lucaspcamargo/hydrus-v1/docs/pics/test-live.jpg

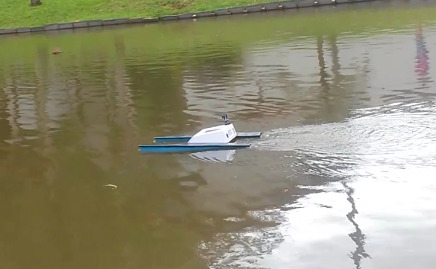
docs/pics/test-live.jpg
