lucaspcamargo/hydrus-v1/docs/proposal/concept-render.jpg

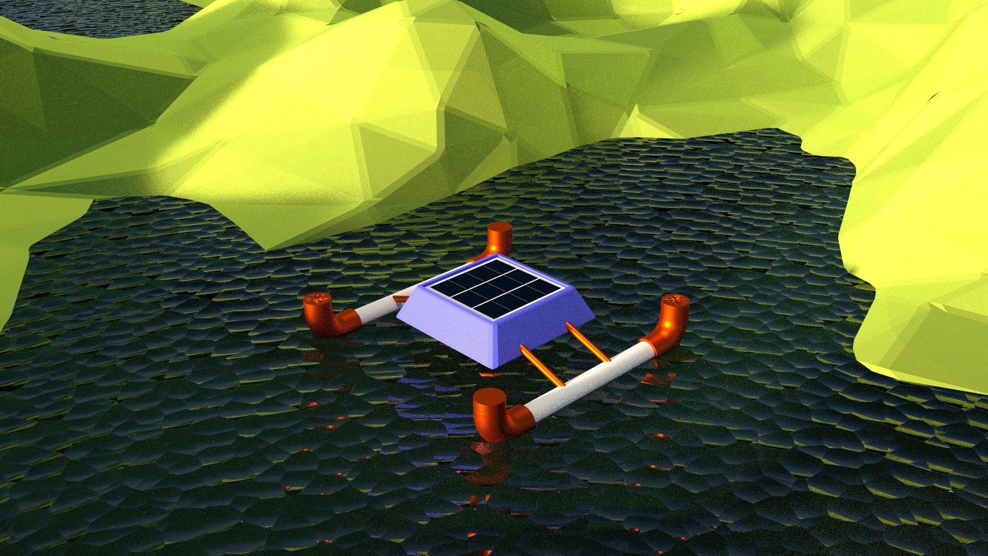
docs/proposal/concept-render.jpg
