lucaspcamargo/hydrus-v1/README.md

# Hydrus v1

Project files for the first version of the Hydrus vehicle (hw, sw, and docs).
