lucaspcamargo/hydrus-v1/docs/banner/method-darkbg.pdf

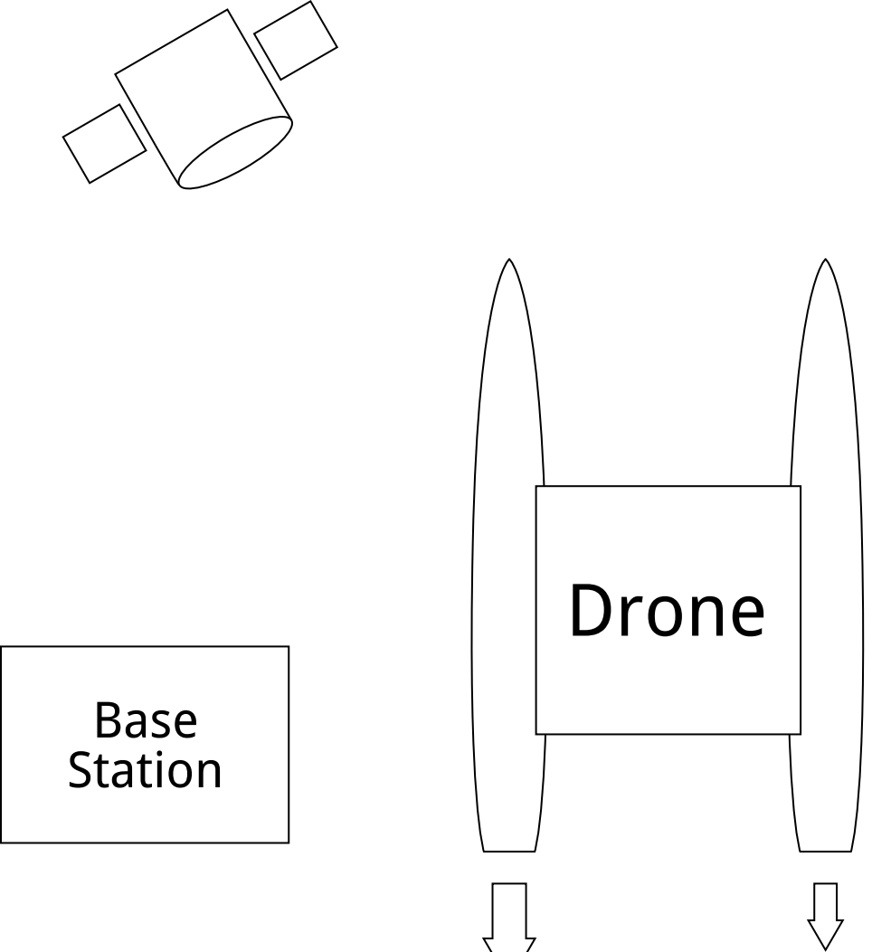
[picture p31: figure]
Drone; - Water PH - Temperature - Turbidity; Base Station; WiFi; GPS; Sensors:; Thrust Vectoring
