lucaspcamargo/hydrus-v1/docs/presentation/presentation.pdf

## Intel Embedded Systems Competition 2016

Organization | Promotion | Sponsorship

# Hydrus – Autonomous Drone for Hydrologic Monitoring

Lucas Pires Camargo
Guilherme Augusto Pangratz
Êmili Bohrer

Professor: Giovani Gracioli
University: Federal University of Santa Catarina – UFSC

# The Hydrus Project

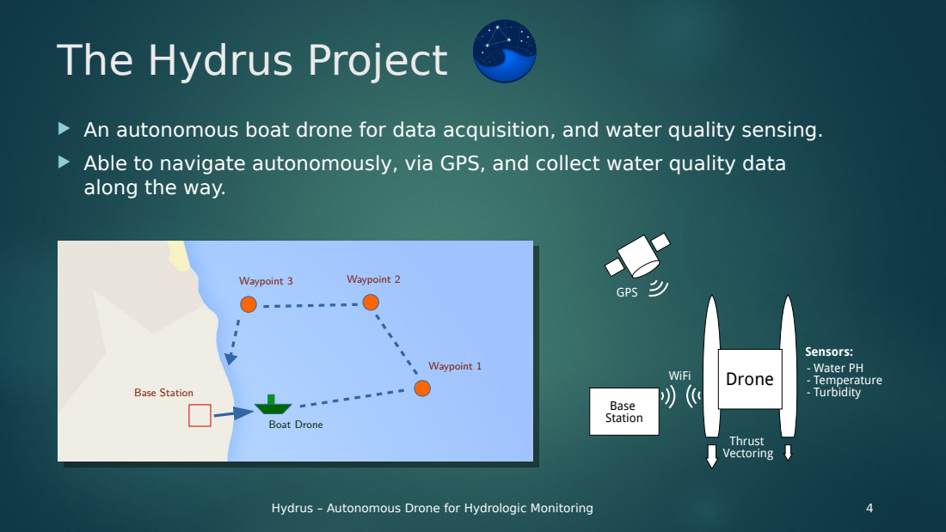
[picture p32: page 2]
Hydrus – Autonomous Drone for Hydrologic Monitoring; Drone; - Water PH - Temperature - Turbidity; Base Station; WiFi; GPS; Sensors:; Thrust Vectoring; Waypoint 3; Waypoint 2; Waypoint 1; Boat Drone

υ An autonomous boat drone for data acquisition, and water quality sensing.
υ Able to navigate autonomously, via GPS, and collect water quality data
along the way.

# Why is it important?

υ 65% of sewage in Brazil is dumped untreated (IGBE + SNIS 2014)
υ Manual monitoring of water in reservoirs is expensive, slow, and sparse.
υ Advances in technology and lowering costs can help solve problems more easily. υ Our drone can…
Increase the number of measurements. Geotag all measurements by default.

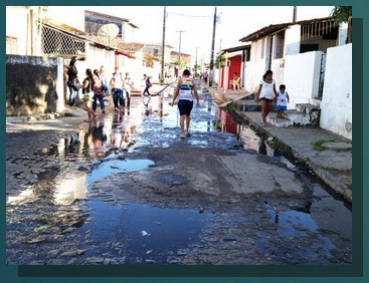
[picture p33: figure]

Open sewage in João Pessoa, PB Source: goo.gl/34XWrf

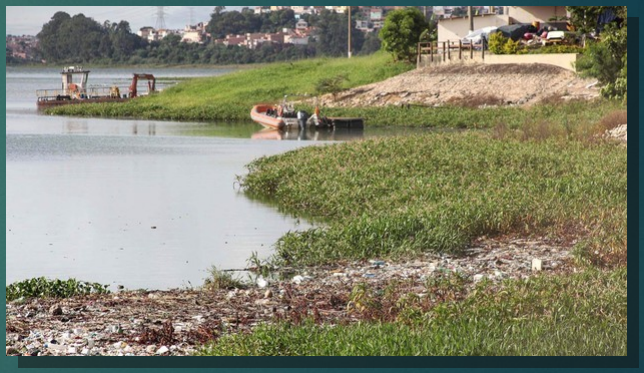
[picture p34: figure]

Garbage floating in a SP reservoir Source: goo.gl/SnBXYp

# Boat Frame

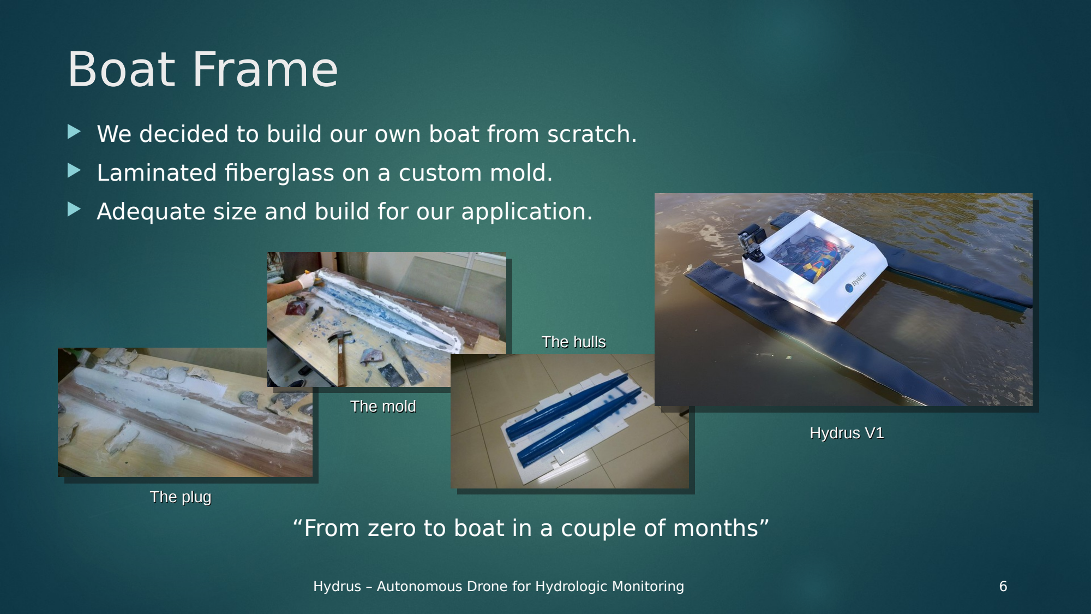
[picture p35: page 4]

υ We decided to build our own boat from scratch. υ Laminated fiberglass on a custom mold.
υ Adequate size and build for our application.

“From zero to boat in a couple of months”

The plug

The mold

The hulls

Hydrus V1

# Hardware

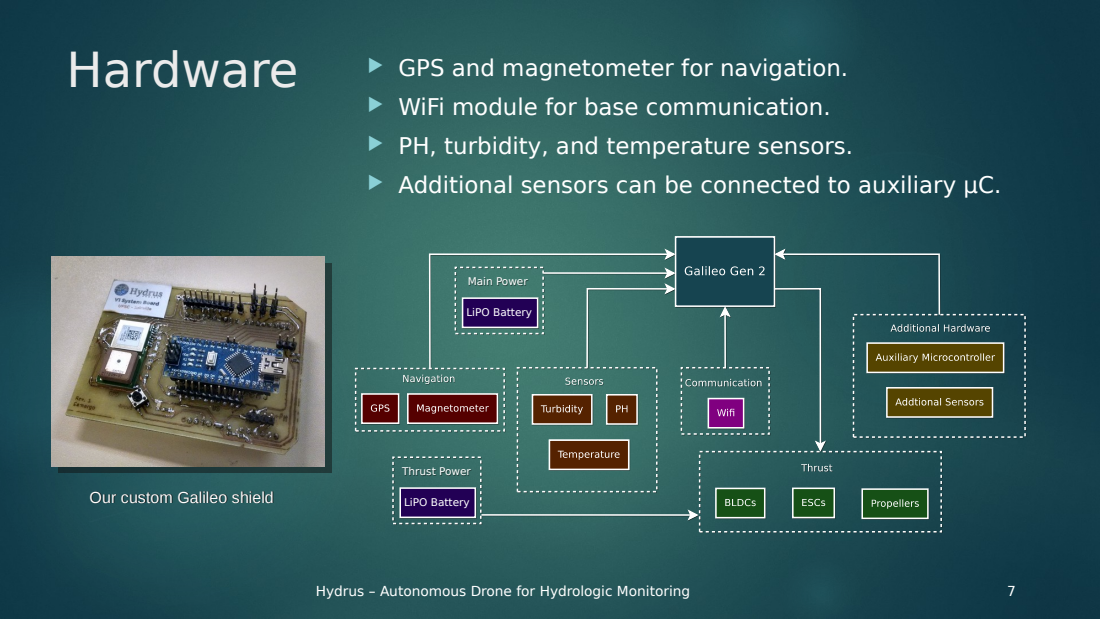
[picture p36: page 5]
Thrust Power; LiPO Battery; Main Power

υ GPS and magnetometer for navigation.
υ WiFi module for base communication.
υ PH, turbidity, and temperature sensors.
υ Additional sensors can be connected to auxiliary µC.

Our custom Galileo shield

# Software

υ Custom built C / C++ firmware, with standard IoT image. υ Cyclic executive scheduler + blackboard architecture.

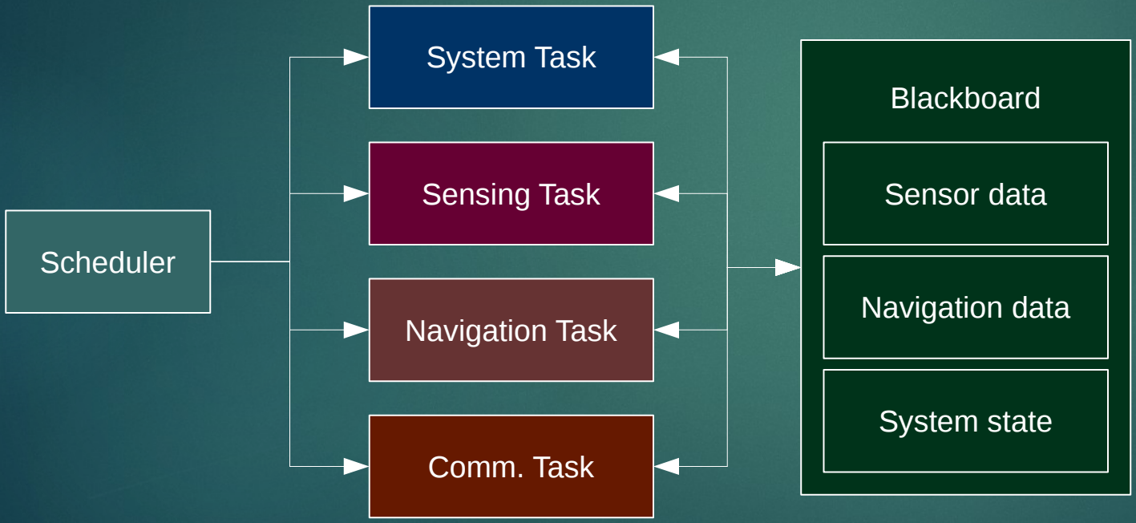
[picture p37: figure]
Scheduler; System Task; Sensing Task; Navigation Task; Comm. Task; Blackboard; Sensor data; System state; Navigation data

Task | Execute (A) | Execute (B) | Period
System | ✓ | ✓ | 0.02s
Sense | ✓ | ✓ | 0.02s
Nav | ✓ | | 0.04s
Comm | | ✓ | 0.04s

Cyclic task Schedule. Major period is 0.04s

# Base Station Software

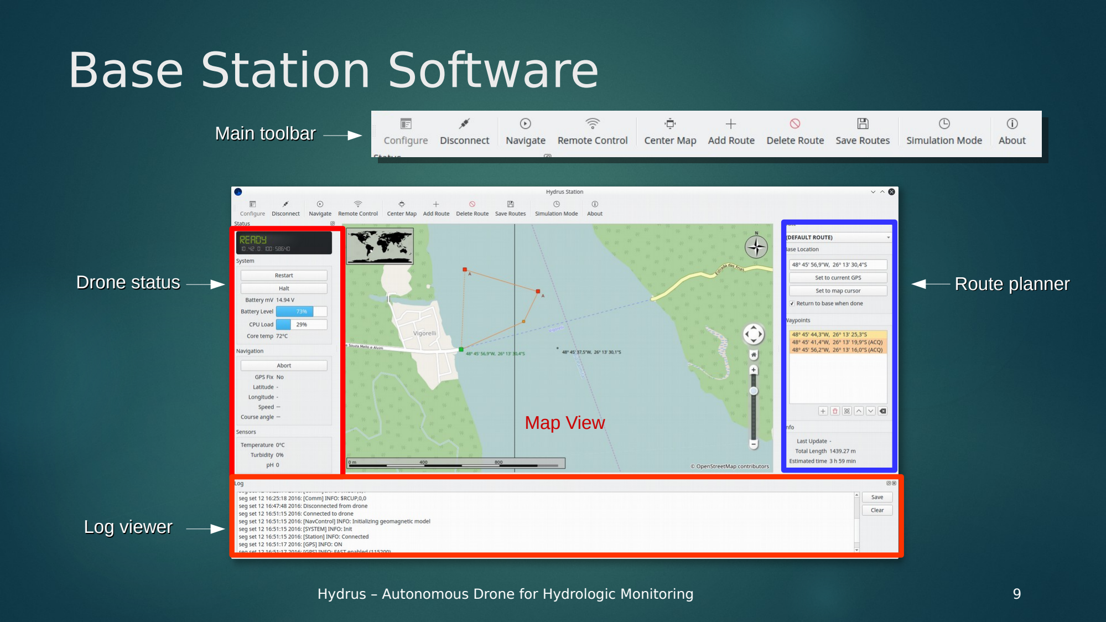
[picture p38: page 7]

Log viewer

Drone status

Main toolbar

Route planner

Map View

# Technical issues

υ We found the Galileo Gen 2 board to be very sensitive.
- Inadequate inrush current protection: we had the regulator catch fire because we plugged the board to a lithium battery (14.5V).
- There should be a separate I2C bus for the onboard peripherals: any interference would bring the sketch to a halt.
- We bricked one probably because the IOREF jumper was loose...

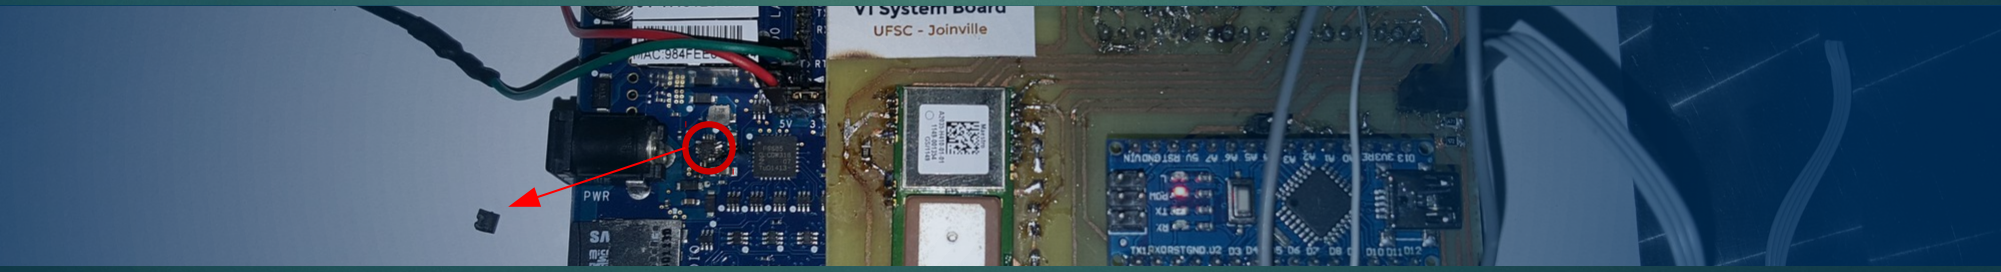
[picture p39: figure]

# Workarounds

υ A couple of boards were brought back to life by supplying +5V directly.
υ We created a GPS-publisher phone app for situations it was hard to get the GPS module to fix to the satellites.
- Overcast weather, old almanac data, etc
Regulator + Filter | Galileo Gen 2

5V_ALWAYS_ON

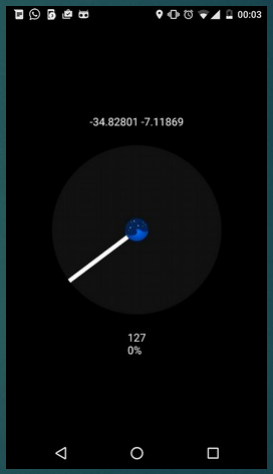
[picture p40: figure]

Helper Android application

Simple solution for blownup regulator (U6)

# Why the project is innovative?

υ A handmade, low-cost boat drone that can navigate autonomously, and collect data on water quality along the way.
υ Modular hardware and software. Custom physical frame.
υ Our drone is a framework that can be easily extended to support additional sensors and applications.

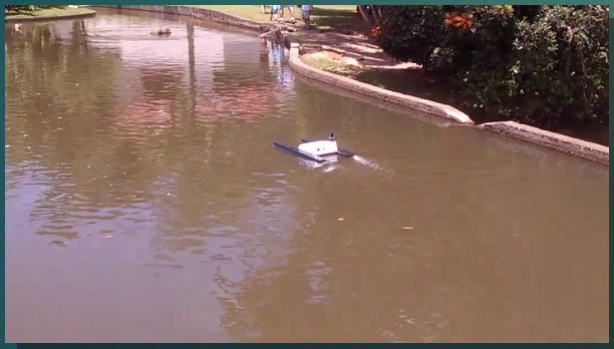
[picture p41: figure]

Item | Price (USD)
Boat frame | $60.00
Battery + Powertrain | $51.00
Galileo Gen 2 | $77.00
Sensors and Modules | $129.00
Total | $317.00

# Results and Future Plans

υ The drone is able to reach programmed waypoints and navigate correctly. υ The companion application allows the user to plot collected data spatially. υ We plan to study the usage of the boat for sonar bathymetry applications. υ We also want to investigate additional energy sources, such as solar.

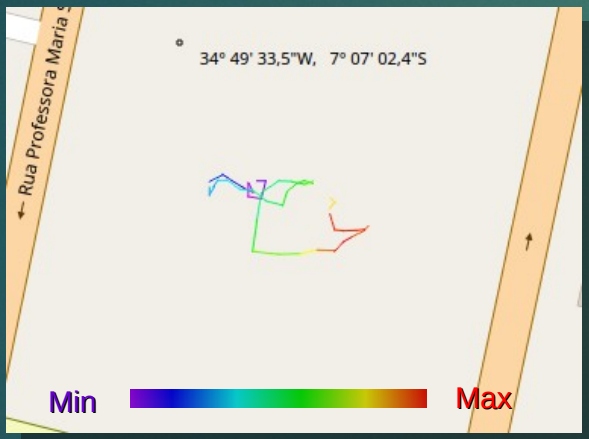
[picture p42: figure]
Min; Max

Plot of collected temperature data on a mock route

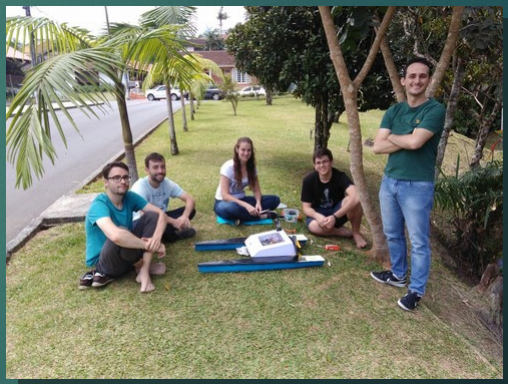
[picture p43: figure]

## Intel® Embedded Systems Competition 2016

# Thank you for your attention!

# Questions?

Organization | Promotion | Sponsorship
