lucaspcamargo/hydrus-v1/docs/software/sw-uml-sense.pdf

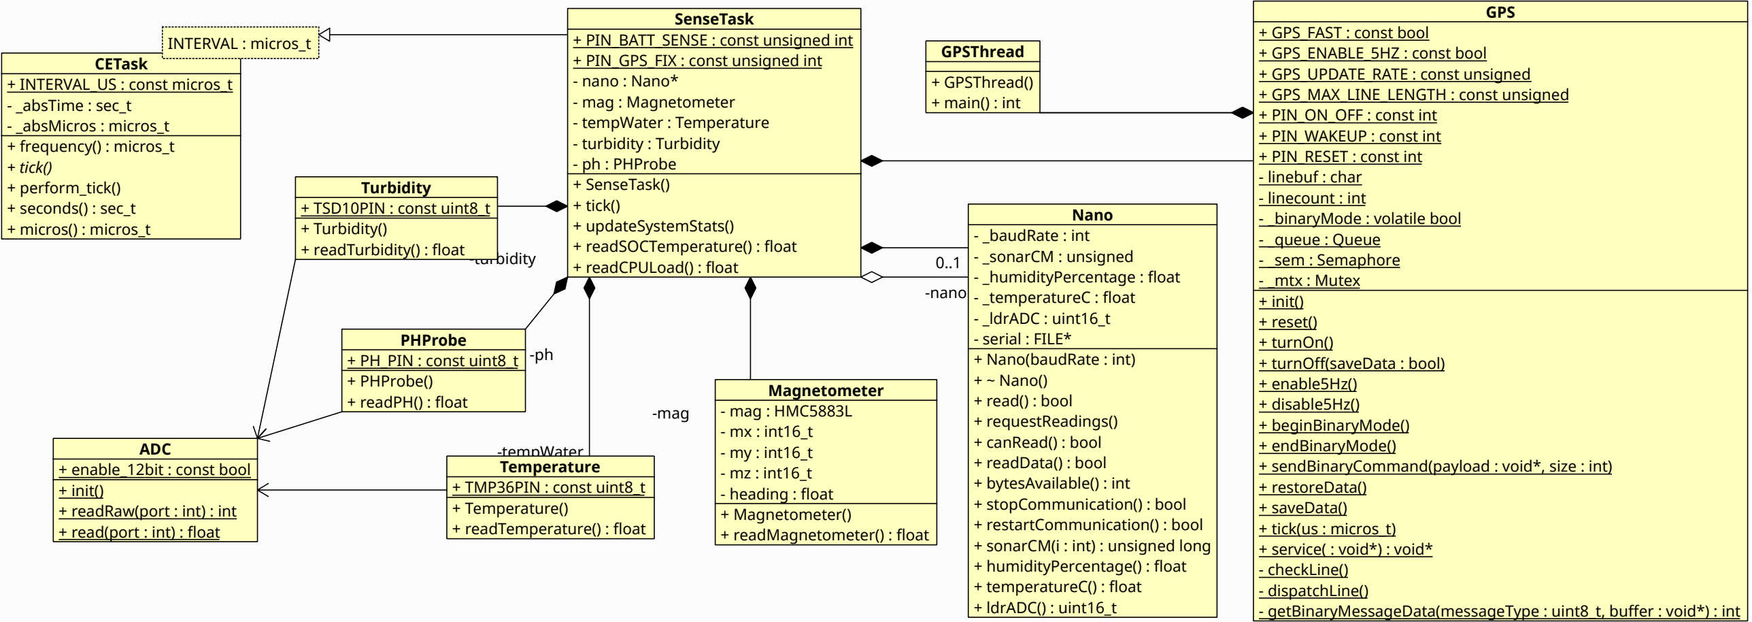
[picture p46: figure]
-turbidity; -mag; ADC + enable_12bit : const bool + init() + readRaw(port : int) : int + read(port : int) : float; 0..1 -nano; -tempWater; INTERVAL : micros_t; CETask + INTERVAL_US : const micros_t - _absTime : sec_t - _absMicros : micros_t + frequency() : micros_t + tick() + perform_tick() + seconds() : sec_t + micros() : micros_t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

+ sendBinaryCommand(payload : void*, size : int)

- getBinaryMessageData(messageType : uint8_t, buffer : void*) : int
