lucaspcamargo/hydrus-v1/docs/branding/board-backside.png

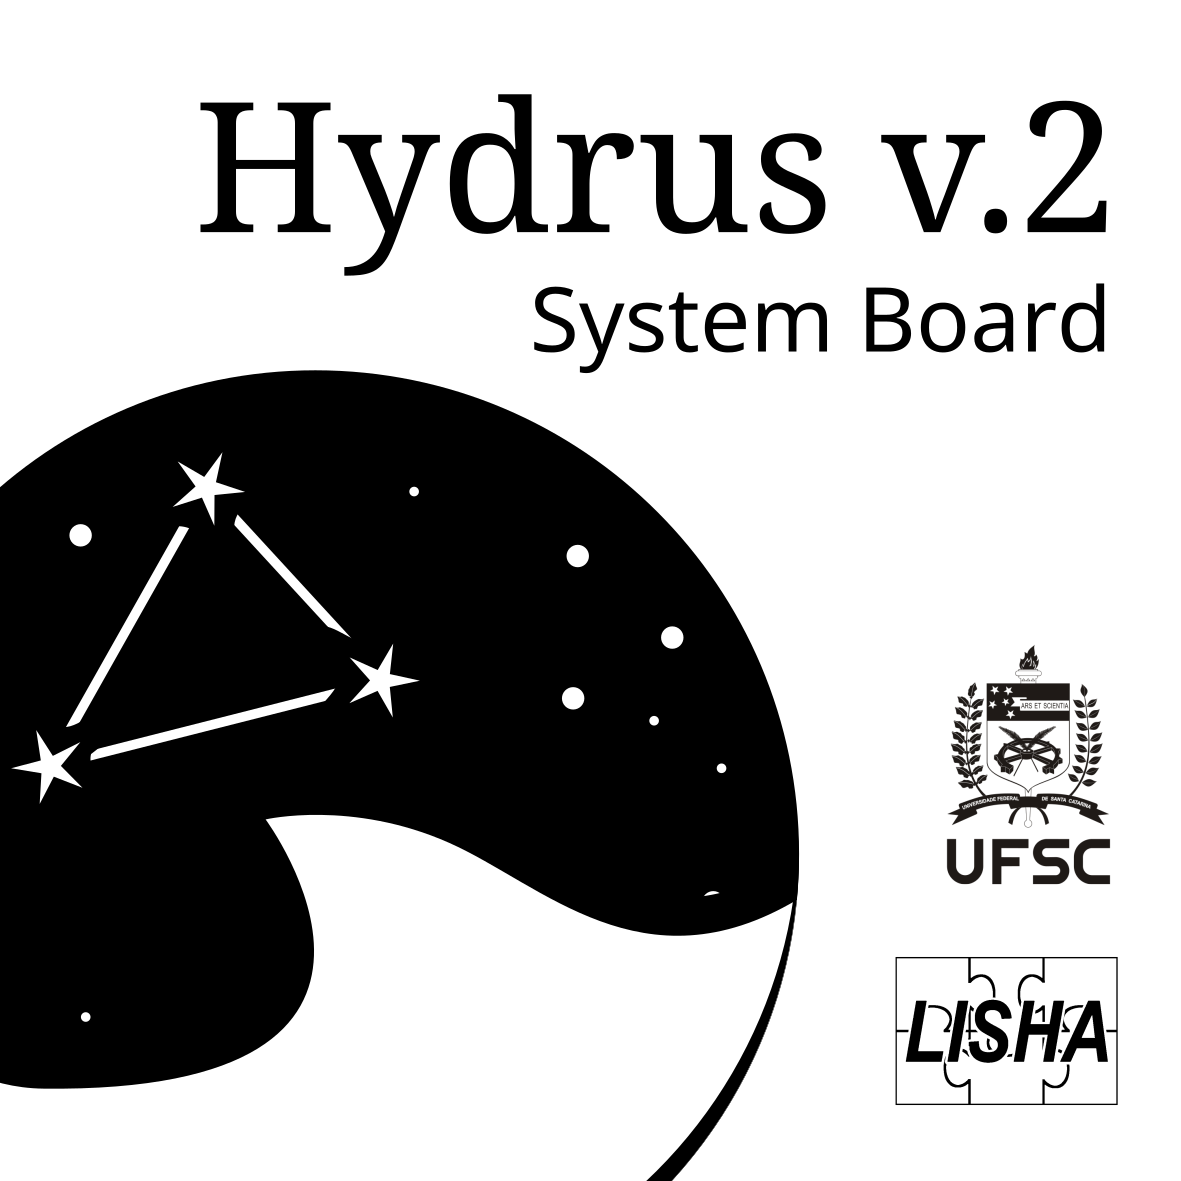
docs/branding/board-backside.png
