lucaspcamargo/hydrus-v1/docs/pics/IMG-20161026-WA0012.jpg

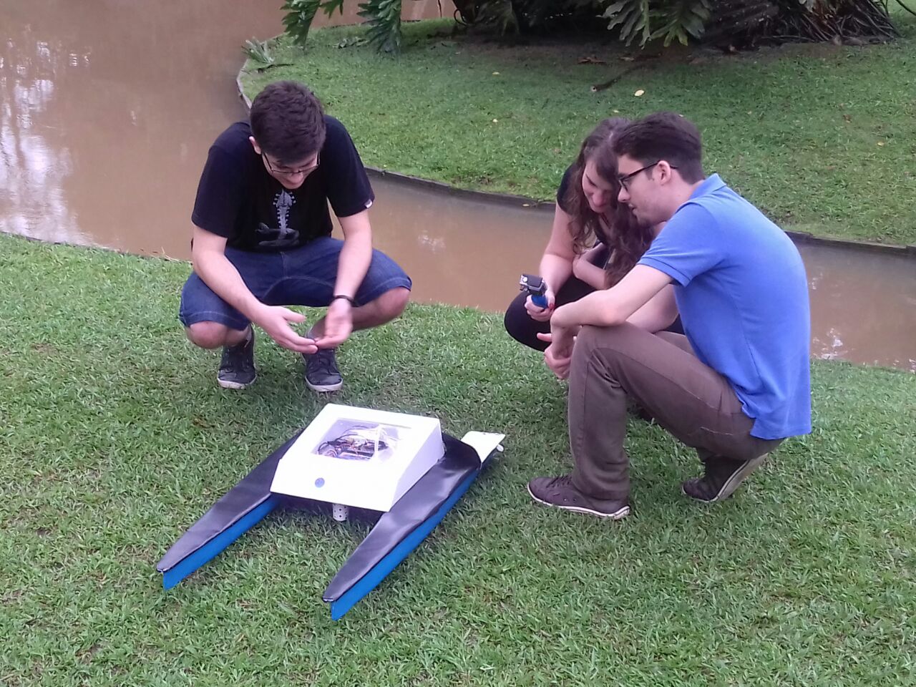
docs/pics/IMG-20161026-WA0012.jpg
