lucaspcamargo/hydrus-v1/docs/pics/IMG-20161103-WA0000.jpg

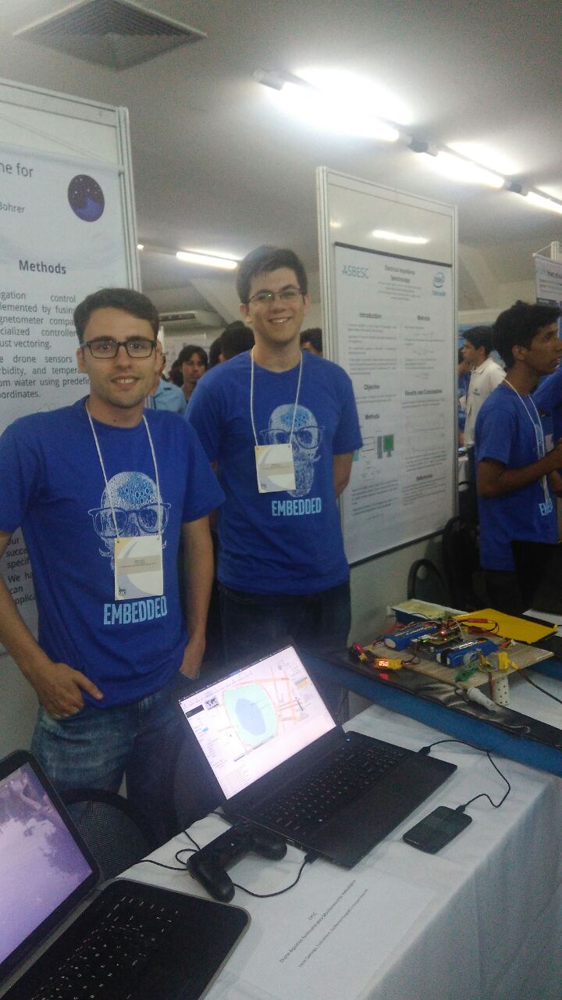
docs/pics/IMG-20161103-WA0000.jpg
