lucaspcamargo/hydrus-v1/docs/pics/IMG_20161027_144656.jpg

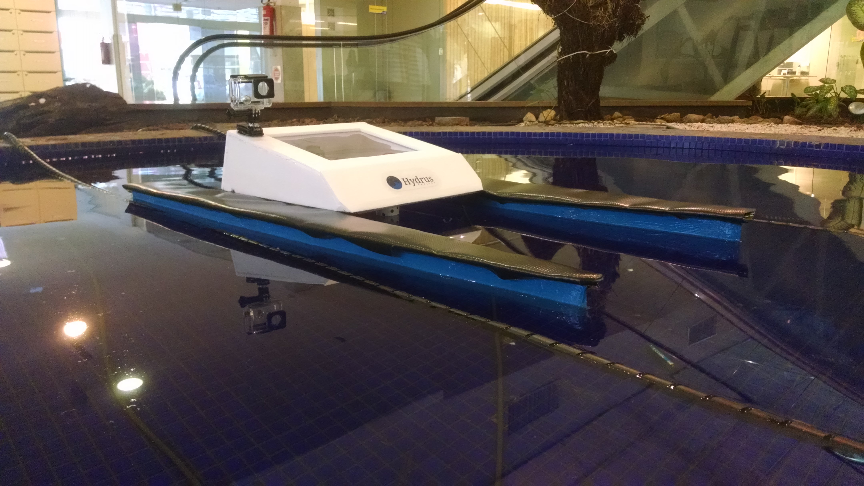
docs/pics/IMG_20161027_144656.jpg
