lucaspcamargo/hydrus-v1/drone-hw/drone-hw-shield-ph/drone-hw-shield-export/decor-300dpi.png

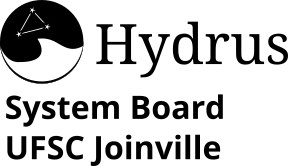
drone-hw/drone-hw-shield-ph/drone-hw-shield-export/decor-300dpi.png
