lucaspcamargo/hydrus-v1/drone-hw/drone-hw-shield-ph/drone-hw-shield-export/decor-600dpi.png

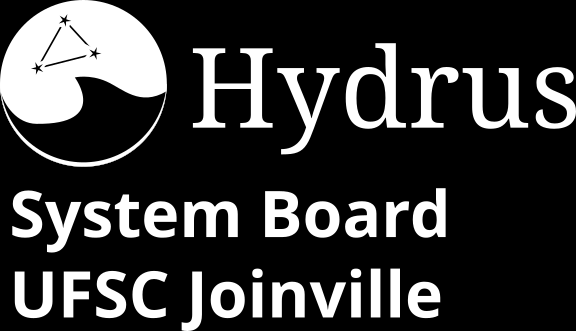
drone-hw/drone-hw-shield-ph/drone-hw-shield-export/decor-600dpi.png
