lucaspcamargo/hydrus-v1/drone-hw/drone-hw-shield-ph/drone-hw-shield/drone-hw-shield-3d.png

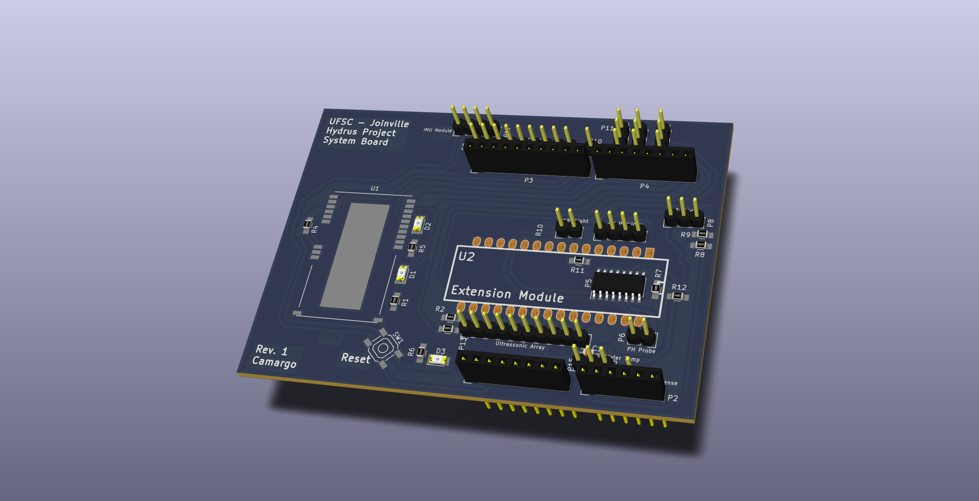
drone-hw/drone-hw-shield-ph/drone-hw-shield/drone-hw-shield-3d.png
