lucaspcamargo/hydrus-v1/docs/hw/componentes-ebay.txt

http://www.ebay.com/itm/Dishwasher-Liquid-Suspended-Particles-Turbidity-Sensor-Detection-Module-Kit/231660801264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

http://www.ebay.com/itm/Liquid-PH0-14-Value-Sensor-Module-BNC-PH-Electrode-Probe-for-Arduino-/201477251356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

http://www.ebay.com/itm/5pcs-20-450-PT100-Platinum-Resister-Temperature-Sensor-Temp-Probe-Waterproof-/391272269639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

http://www.ebay.com/itm/Ultraschall-Sensor-Ultrasonic-Module-Abstandsmessung-fur-Arduino-Waterproof-3-5M-/121796151959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

-- 
-- 

Prof. Anderson W. Spengler, Dr.

UFSC - Universidade Federal de Santa Catarina

Centro de Engenharias da Mobilidade (CEM)
Joinville, SC, Brasil

Tel 1: +55 (48) 3721 7334
Tel 2: +55 (47) 3461 5900 (ramal 7334)
