lucaspcamargo/hydrus-v1/drone-hw/drone-3dprint-parts/export/mpcie-adapter.stl

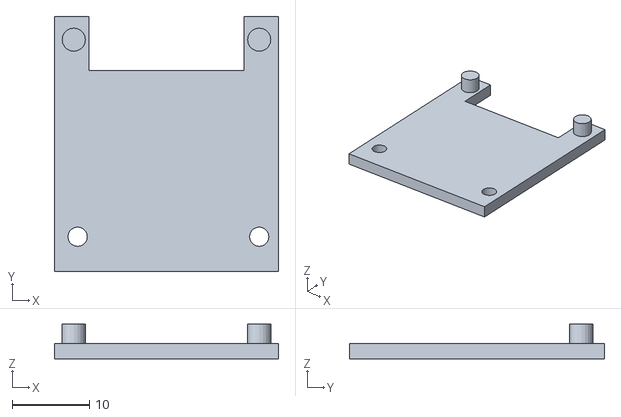
[picture p59: CAD file, 2018-08-02]
drone-hw/drone-3dprint-parts/export/mpcie-adapter.stl
29.0 x 33.0 x 4.50
