lucaspcamargo/hydrus-v1/drone-hw/drone-3dprint-parts/export/axle-adapter.stl

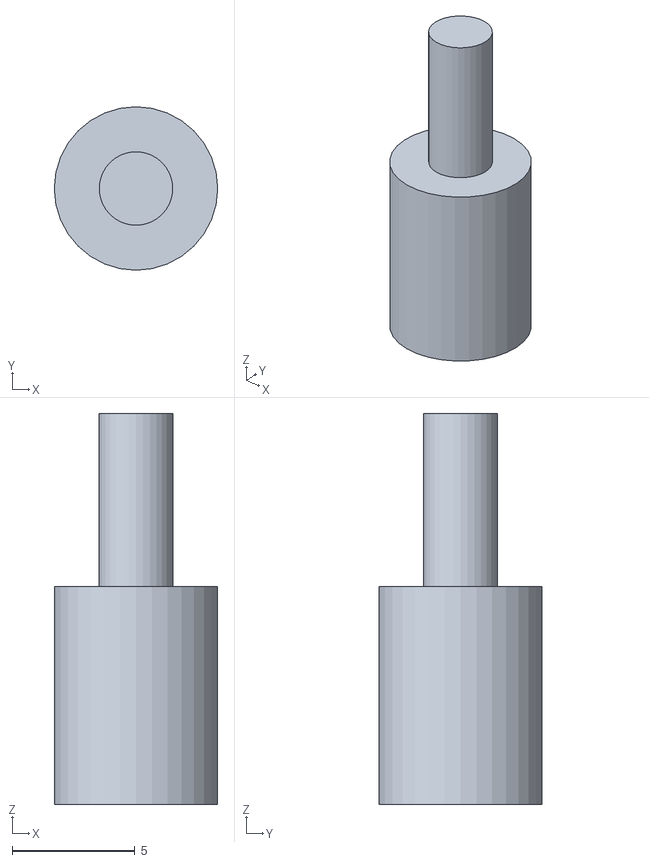
[picture p60: CAD file, 2018-08-02]
drone-hw/drone-3dprint-parts/export/axle-adapter.stl
6.67 x 6.67 x 16.0
