lucaspcamargo/hydrus-v1/drone-hw/drone-3dprint-parts/export/propeller-original.stl

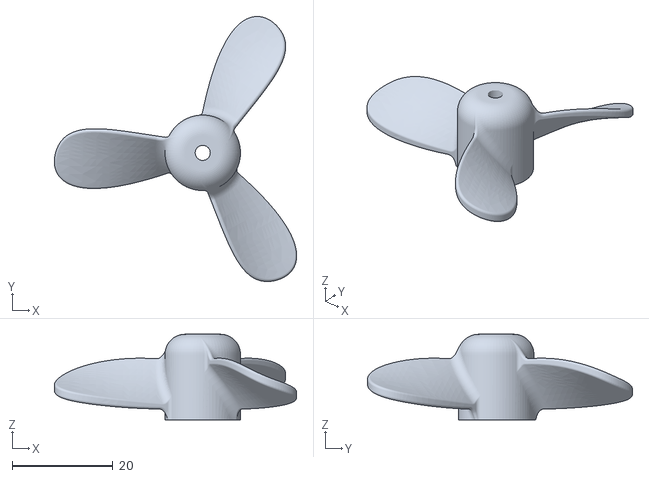
[picture p61: CAD file, 2018-08-02]
drone-hw/drone-3dprint-parts/export/propeller-original.stl
48.2 x 52.7 x 17.0
