lucaspcamargo/hydrus-v1/drone-hw/drone-3dprint-parts/export/galileo-support.stl

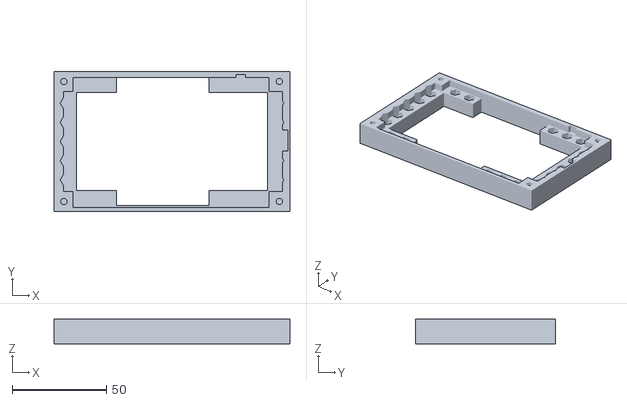
[picture p62: CAD file, 2018-08-02]
drone-hw/drone-3dprint-parts/export/galileo-support.stl
125.0 x 74.0 x 13.0
