lucaspcamargo/hydrus-v1/drone-hw/drone-3dprint-parts/export/propeller.stl

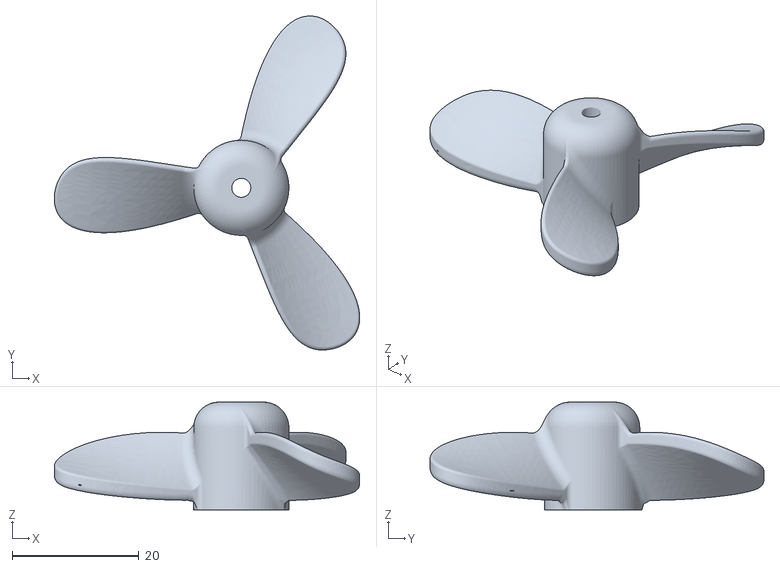
[picture p63: CAD file, 2018-08-02]
drone-hw/drone-3dprint-parts/export/propeller.stl
48.2 x 52.7 x 17.0
