lucaspcamargo/hydrus-v1/(list of files, cad)

Other CAD files:
docs/proposal/vis.blend
