lucaspcamargo/hydrus-v1/docs/banner/method.pdf

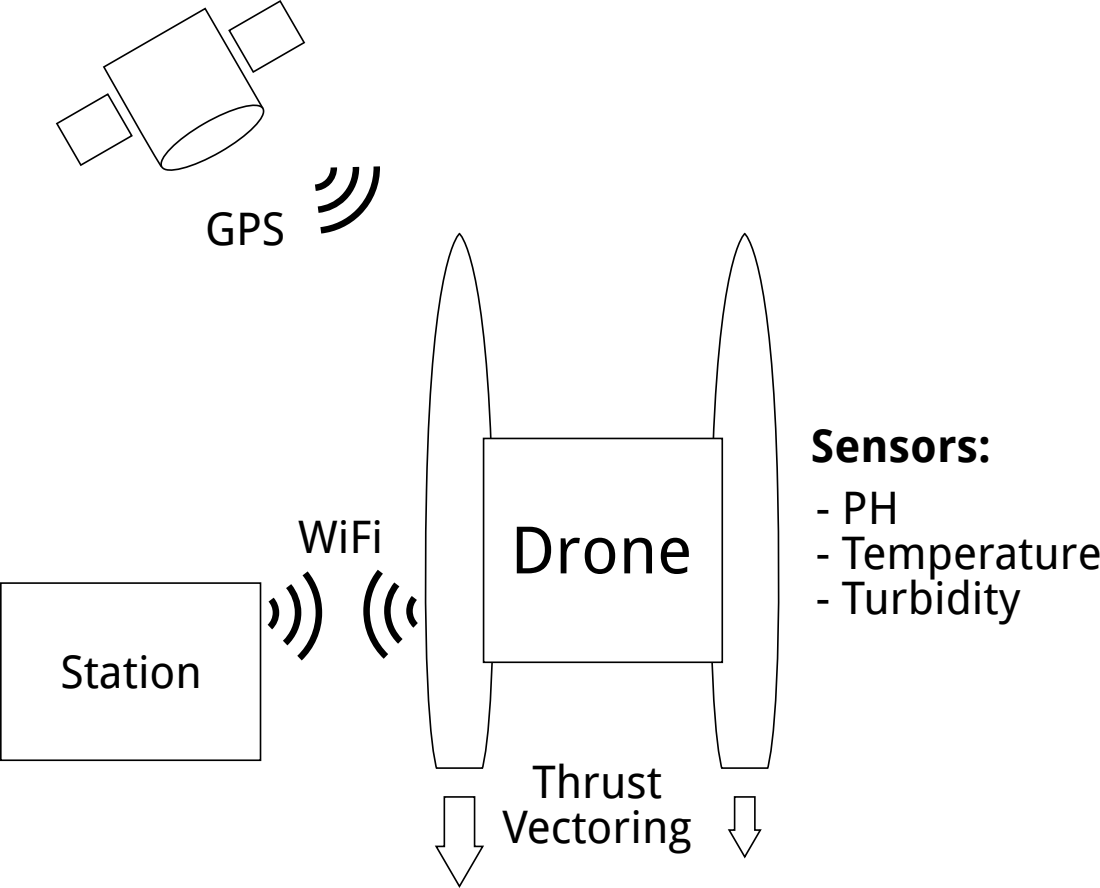
[picture p64: page 1]
Drone; - PH - Temperature - Turbidity; Station; WiFi; GPS; Sensors:; Thrust Vectoring
