lucaspcamargo/hydrus-v1/drone-hw/drone-hw-shield/stickers/sticker.pdf

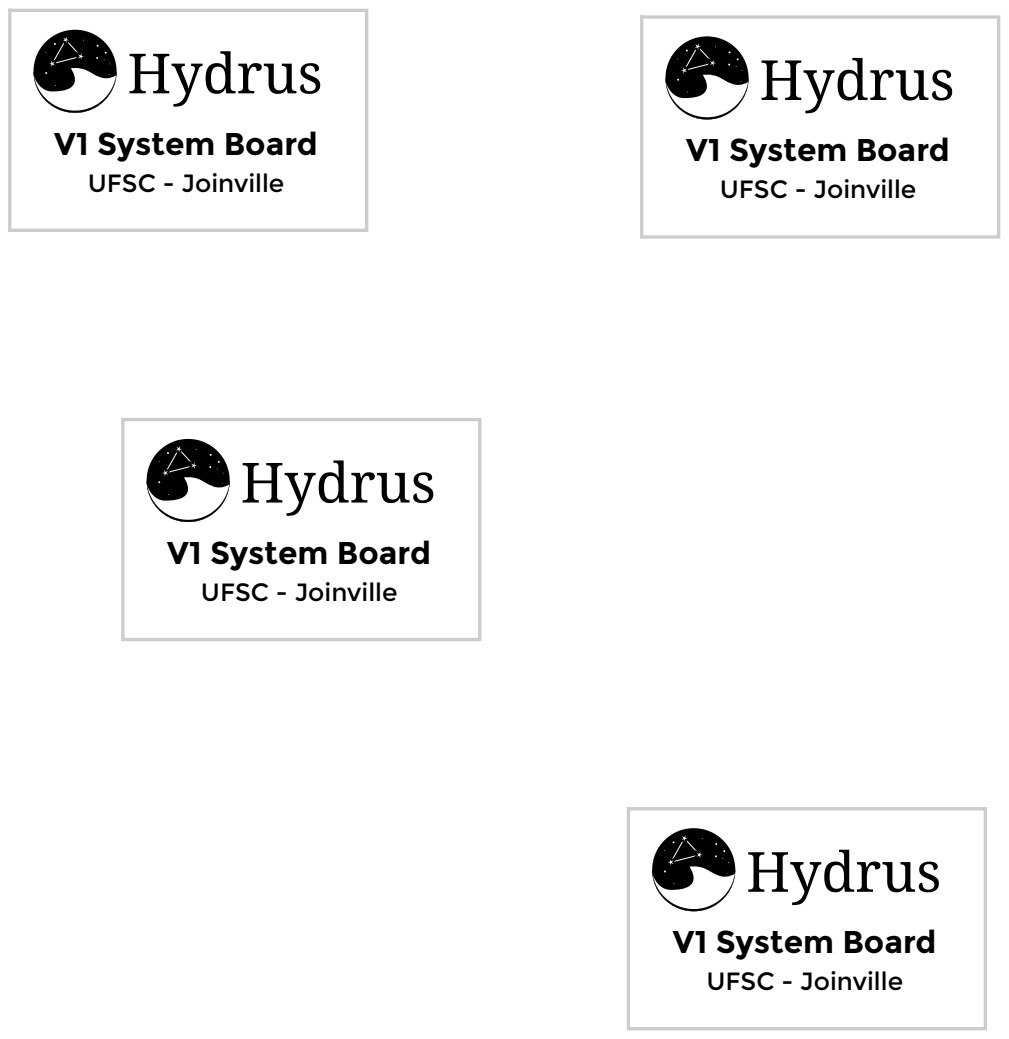
[picture p65: page 1]
Hydrus; V1 System Board UFSC - Joinville
