lucaspcamargo/hydrus-v1/drone-hw/drone-hw-shield/drone-hw-shield-schematic.pdf

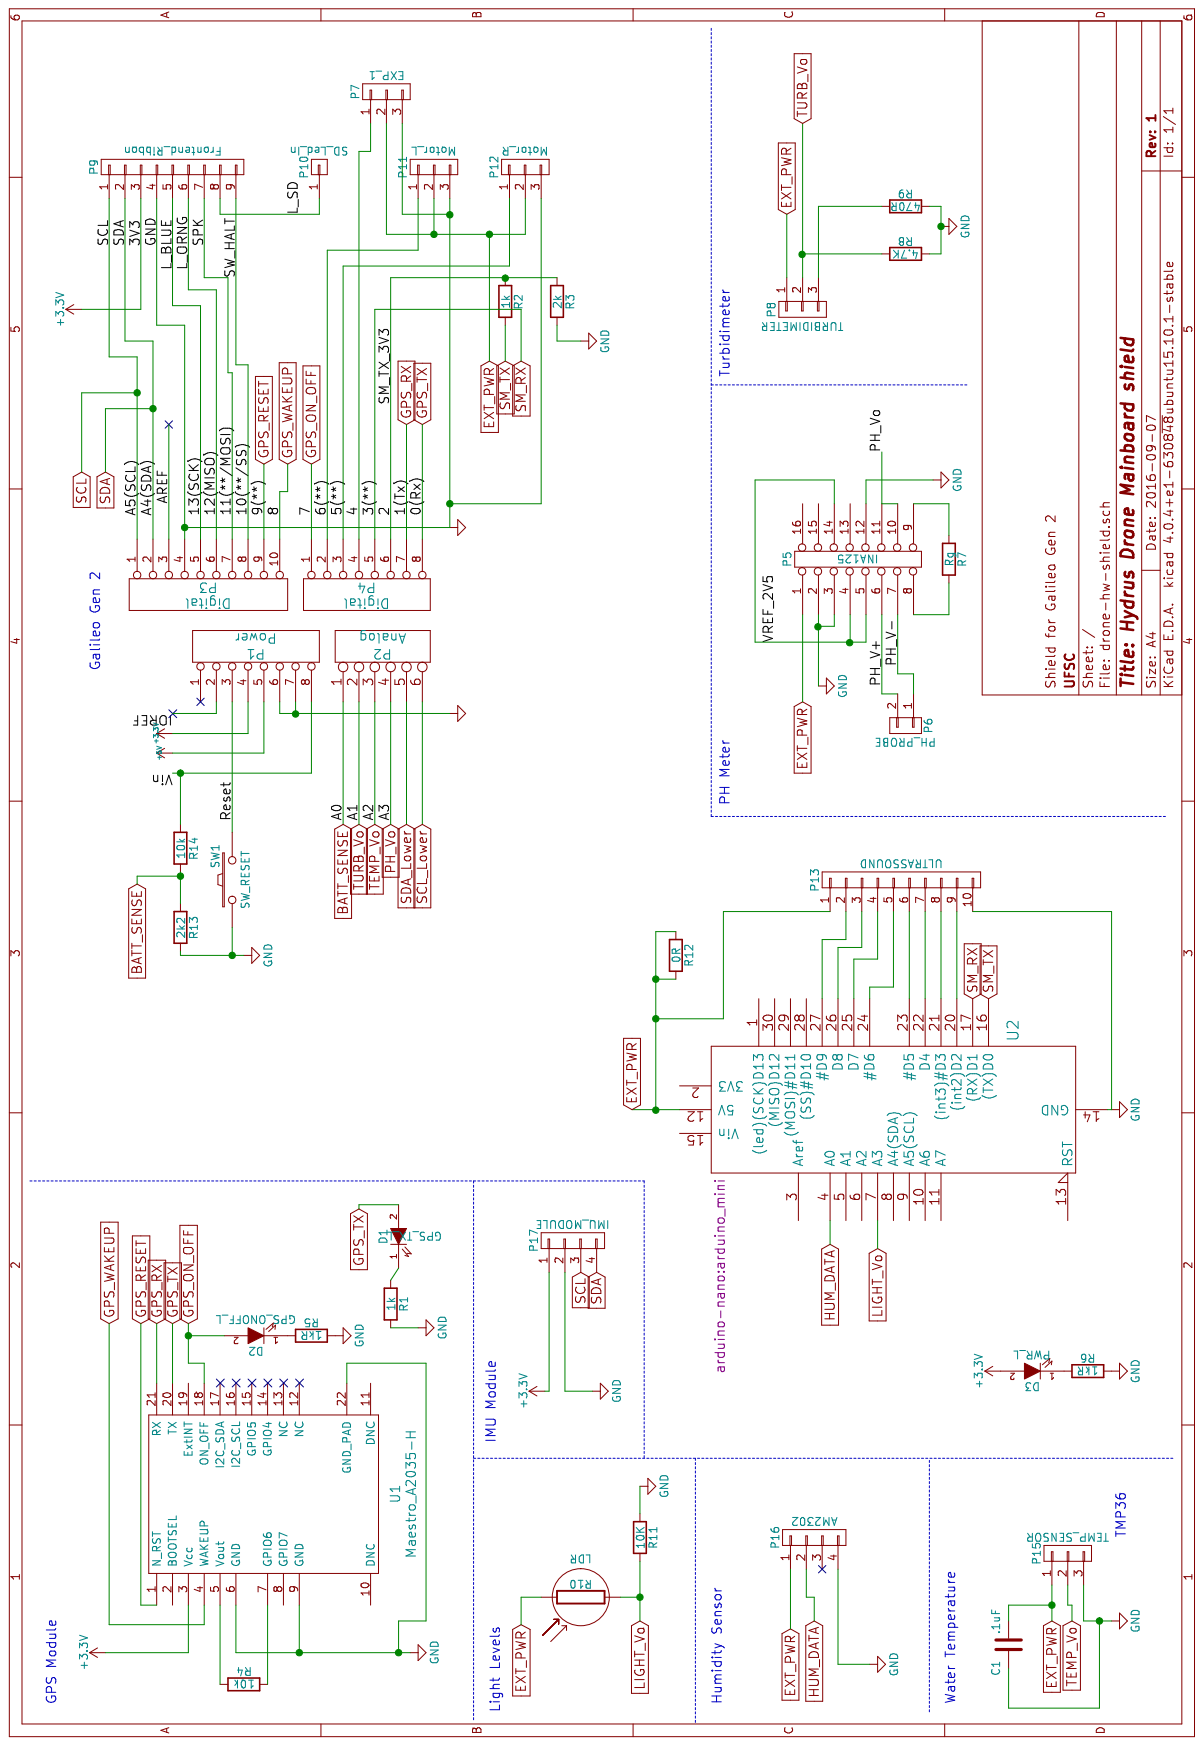
[picture p66: page 1]
