lucaspcamargo/hydrus-v1/docs/branding/project-logo-v2-darkbg.pdf

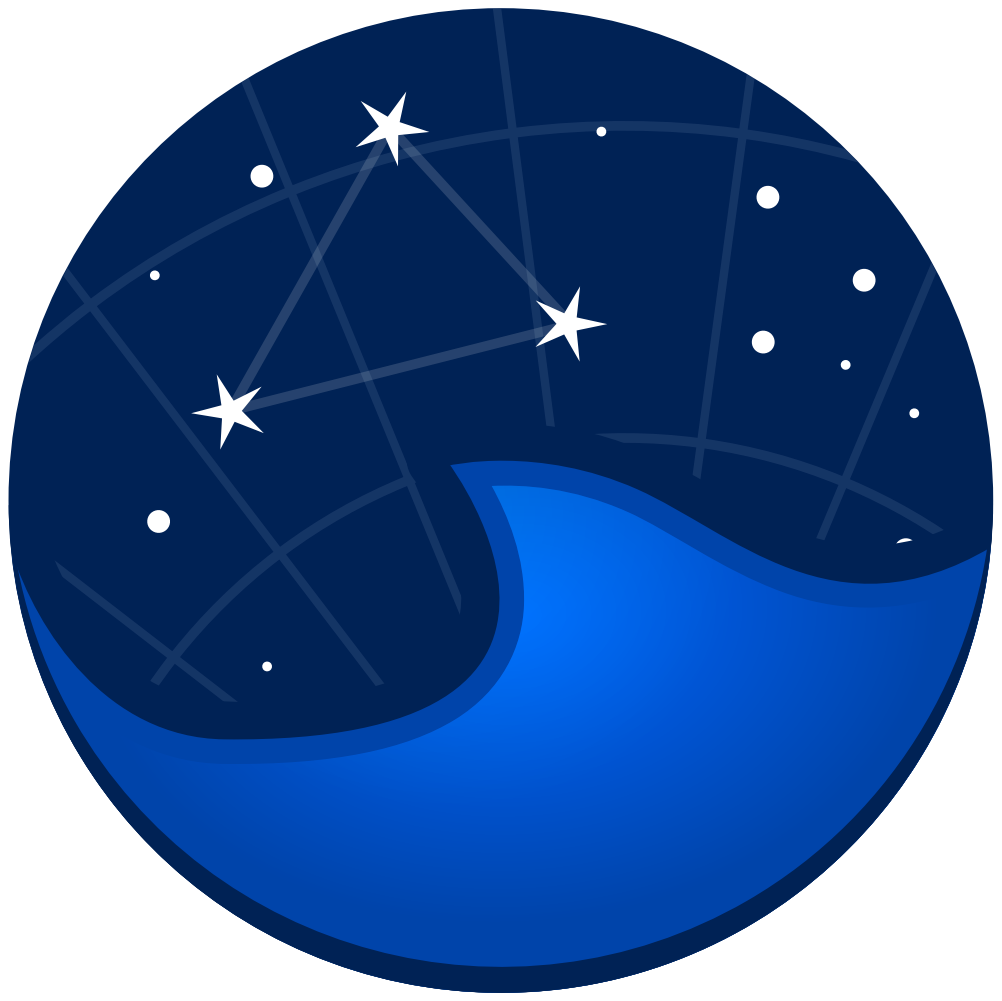
[picture p67: page 1]
Hydrus P R O J E C T
