lucaspcamargo/hydrus-v1/docs/software/sw-uml-nav-state.pdf

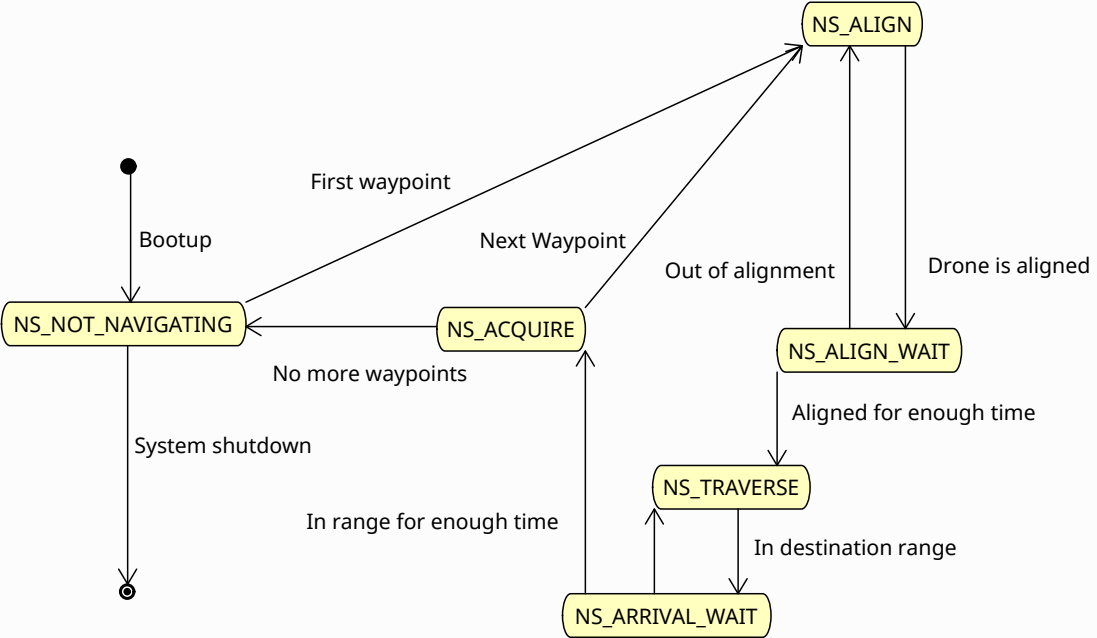
[picture p68: page 1]
NS_ALIGN; NS_NOT_NAVIGATING; NS_ALIGN_WAIT; NS_TRAVERSE; NS_ARRIVAL_WAIT; First waypoint; Out of alignment; Drone is aligned; NS_ACQUIRE; Next Waypoint; System shutdown; Bootup

No more waypoints

Aligned for enough time

In range for enough time

In destination range
