lucaspcamargo/hydrus-v1/(list of files, drawings)

Other design files:
drone-hw/drone-v2-systemboard/drone-v2-systemboard.dsn
drone-hw/drone-v2-systemboard/routing/drone-v2-systemboard.dsn
