lucaspcamargo/hydrus-v1/drone-hw/drone-hw-shield/drone-hw-shield/drone-hw-shield.kicad_pcb

## KiCad design drone-hw/drone-hw-shield/drone-hw-shield/drone-hw-shield.kicad_pcb (2018-08-02)

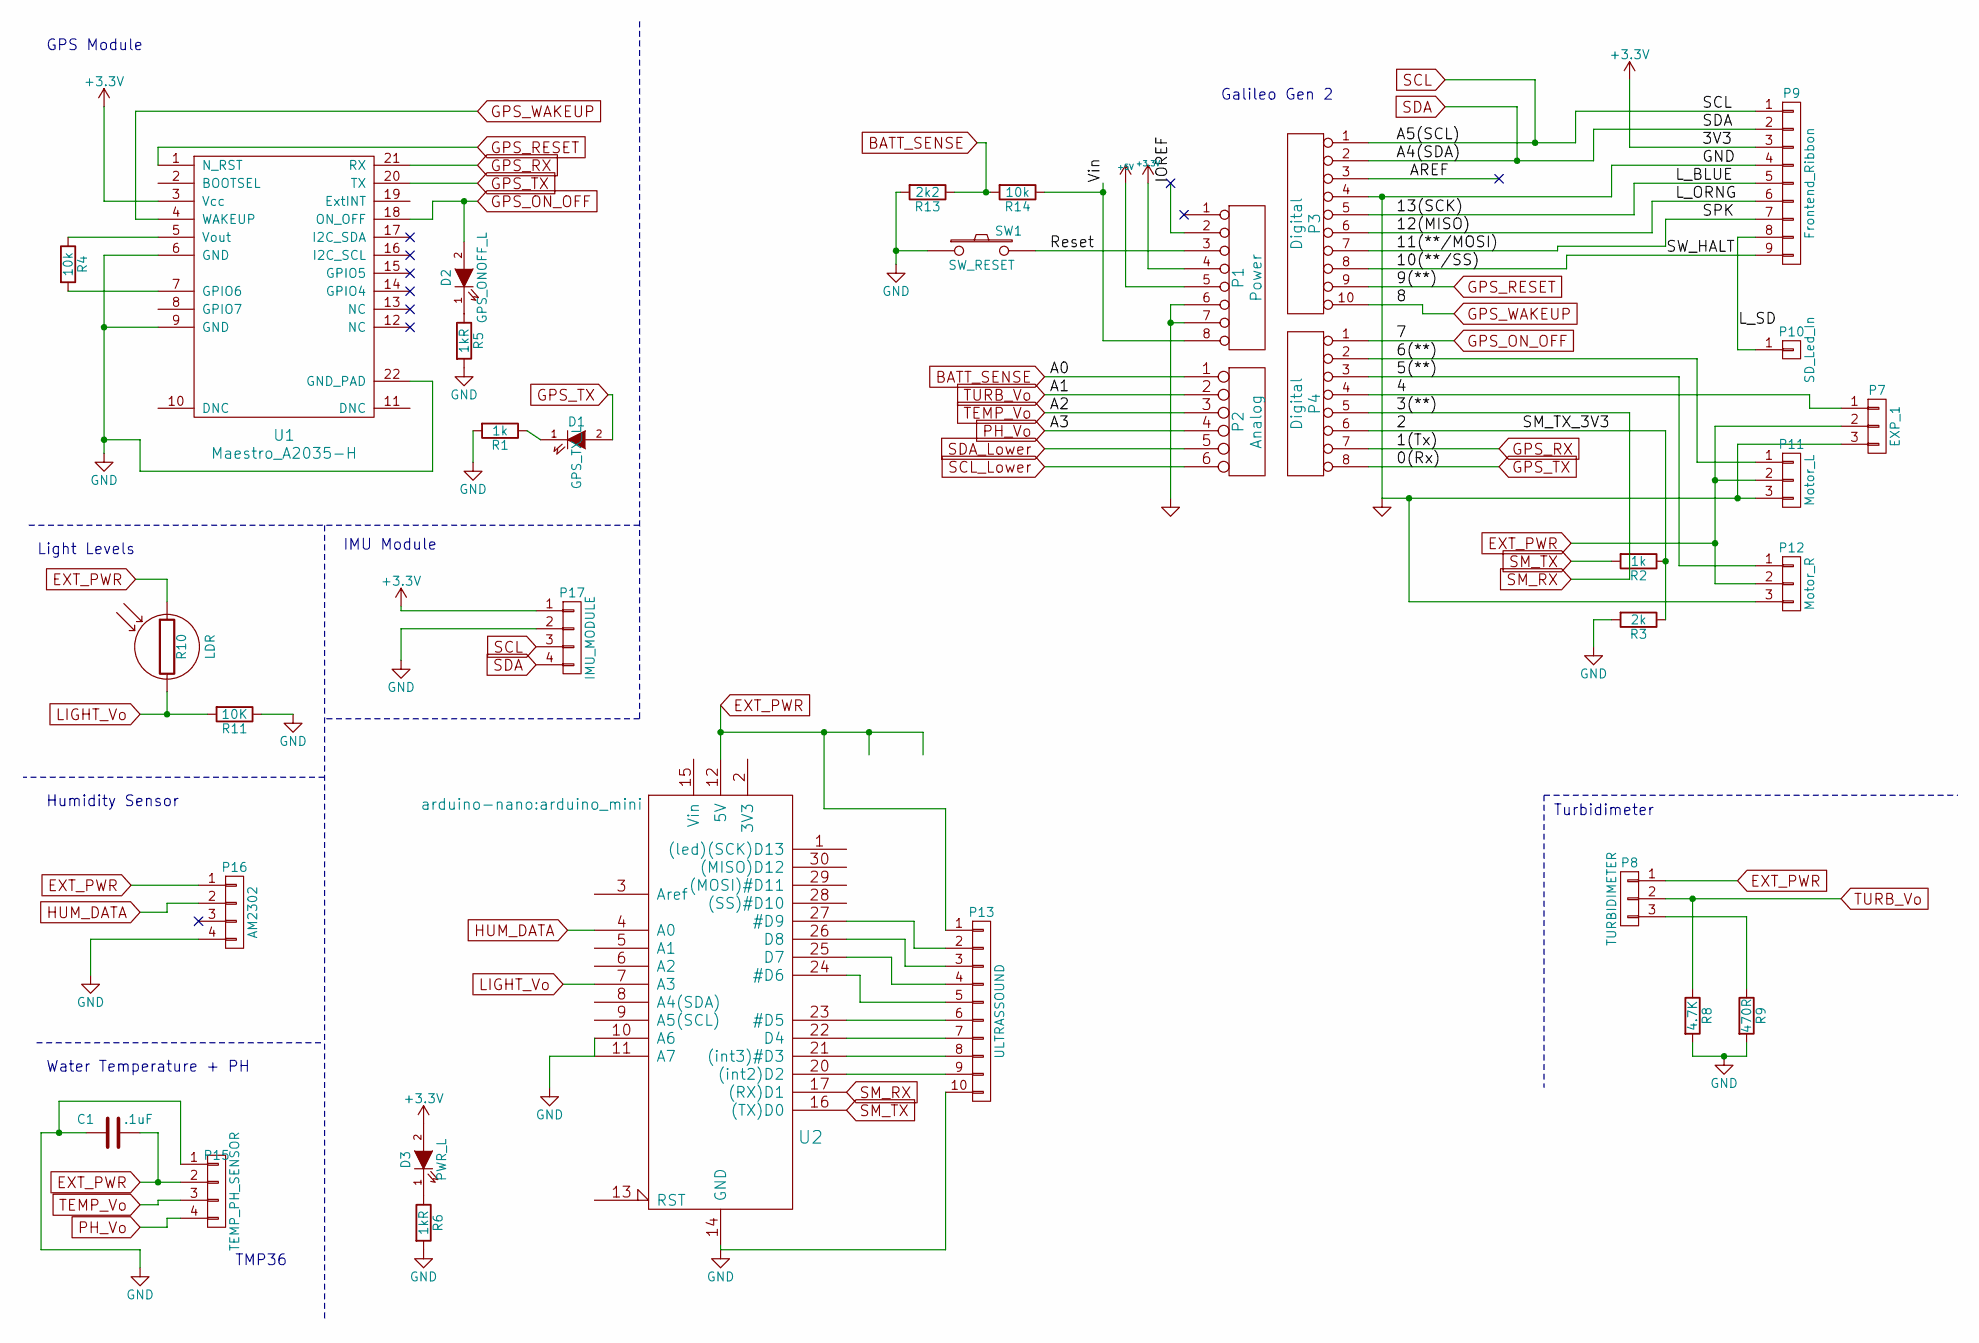
[picture p69: schematic drone-hw-shield.sch, Hydrus Drone Mainboard shield]

Parts:
C1: .1uF; C_0805_HandSoldering
D1: GPS_TX_L; LED_1206
D2: GPS_ONOFF_L; LED_1206
D3: PWR_L; LED_1206
P1: Power; Socket_Strip_Arduino_1x08
P2: Analog; Socket_Strip_Arduino_1x06
P3: Digital; Socket_Strip_Arduino_1x10
P4: Digital; Socket_Strip_Arduino_1x08
P7: EXP_1; Pin_Header_Straight_1x03
P8: TURBIDIMETER; Pin_Header_Straight_1x03
P9: Frontend_Ribbon; Pin_Header_Straight_1x09
P10: SD_Led_In; Pin_Header_Straight_1x01
P11: Motor_L; Pin_Header_Straight_1x03
P12: Motor_R; Pin_Header_Straight_1x03
P13: ULTRASSOUND; Pin_Header_Straight_1x10
P15: TEMP_PH_SENSOR; Pin_Header_Straight_1x04
P16: AM2302; Pin_Header_Straight_1x04
P17: IMU_MODULE; Pin_Header_Straight_1x04
R1, R2: 1k; R_0805_HandSoldering
R3: 2k; R_0805_HandSoldering
R4: 10k; R_0805_HandSoldering
R5, R6: 1kR; R_0805_HandSoldering
R8: 4.7K; R_0805_HandSoldering
R9: 470R; R_0805_HandSoldering
R10: LDR; Pin_Header_Straight_1x02
R11: 10K; R_0805_HandSoldering
R13: 2k2; R_0805
R14: 10k; R_0805
SW1: SW_RESET; SW_SPST_SKQG
U1: Maestro_A2035-H; Maestro_Module
U2: Extension Module; arduino_mini

Connections:
+3V3: D3.2 (A), P1.4, P9.3, P17.1, U1.3 (Vcc)
+5V: P1.5
/2: P4.6, R2.1, R3.1
/4: P4.4, P7.1
/5(**): P4.3, P12.1
/6(**): P4.2, P11.1
/10(**/SS): P3.8, P9.9
/11(**/MOSI): P3.7, P9.7
/12(MISO): P3.6, P9.6
/13(SCK): P3.5, P9.5
/AREF: P3.3
/IOREF: P1.2
/L_SD: P9.8, P10.1
/Reset: P1.3, SW1.2
/Vin: P1.8, R14.1
BATT_SENSE: P2.1, R13.1, R14.2
EXT_PWR: C1.2, P7.2, P8.1, P11.2, P12.2, P13.1, P15.2, P16.1, R10.1, U2.12 (5V)
GND: C1.1, P1.6, P1.7, P3.4, P7.3, P9.4, P11.3, P12.3, P13.10, P15.1, P16.4, P17.2, R1.2, R3.2, R5.2, R6.2, R8.2, R9.2, R11.1, R13.2, SW1.1, U1.6 (GND), U1.9 (GND), U1.22 (GND_PAD), U2.10 (A6), U2.11 (A7), U2.14 (GND), U2.19 (GND)
GPS_ON_OFF: D2.2 (A), P4.1, U1.18 (ON_OFF)
GPS_RESET: P3.9, U1.1 (N_RST)
GPS_RX: P4.7, U1.21 (RX)
GPS_TX: D1.2 (A), P4.8, U1.20 (TX)
GPS_WAKEUP: P3.10, U1.4 (WAKEUP)
HUM_DATA: P16.2, U2.4 (A0)
LIGHT_Vo: R10.2, R11.2, U2.7 (A3)
unnamed: D1.1 (K), R1.1
unnamed: D2.1 (K), R5.1
unnamed: D3.1 (K), R6.1
unnamed: P8.3, R9.1
unnamed: P13.2, U2.27 (#D9)
unnamed: P13.3, U2.26 (D8)
unnamed: P13.4, U2.25 (D7)
unnamed: P13.5, U2.24 (#D6)
unnamed: P13.6, U2.23 (#D5)
unnamed: P13.7, U2.22 (D4)
unnamed: P13.8, U2.21 ((int3)#D3)
unnamed: P13.9, U2.20 ((int2)D2)
unnamed: R4.1, U1.5 (Vout)
unnamed: R4.2, U1.7 (GPIO6)
PH_Vo: P2.4, P15.4
SCL: P3.1, P9.1, P17.3
SCL_Lower: P2.6
SDA: P3.2, P9.2, P17.4
SDA_Lower: P2.5
SM_RX: P4.5, U2.17 ((RX)D1)
SM_TX: R2.2, U2.16 ((TX)D0)
TEMP_Vo: P2.3, P15.3
TURB_Vo: P2.2, P8.2, R8.1

Notes on the sheet:
Turbidimeter
GPS Module
Galileo Gen 2
Light Levels
Water Temperature + PH
TMP36
IMU Module
Humidity Sensor

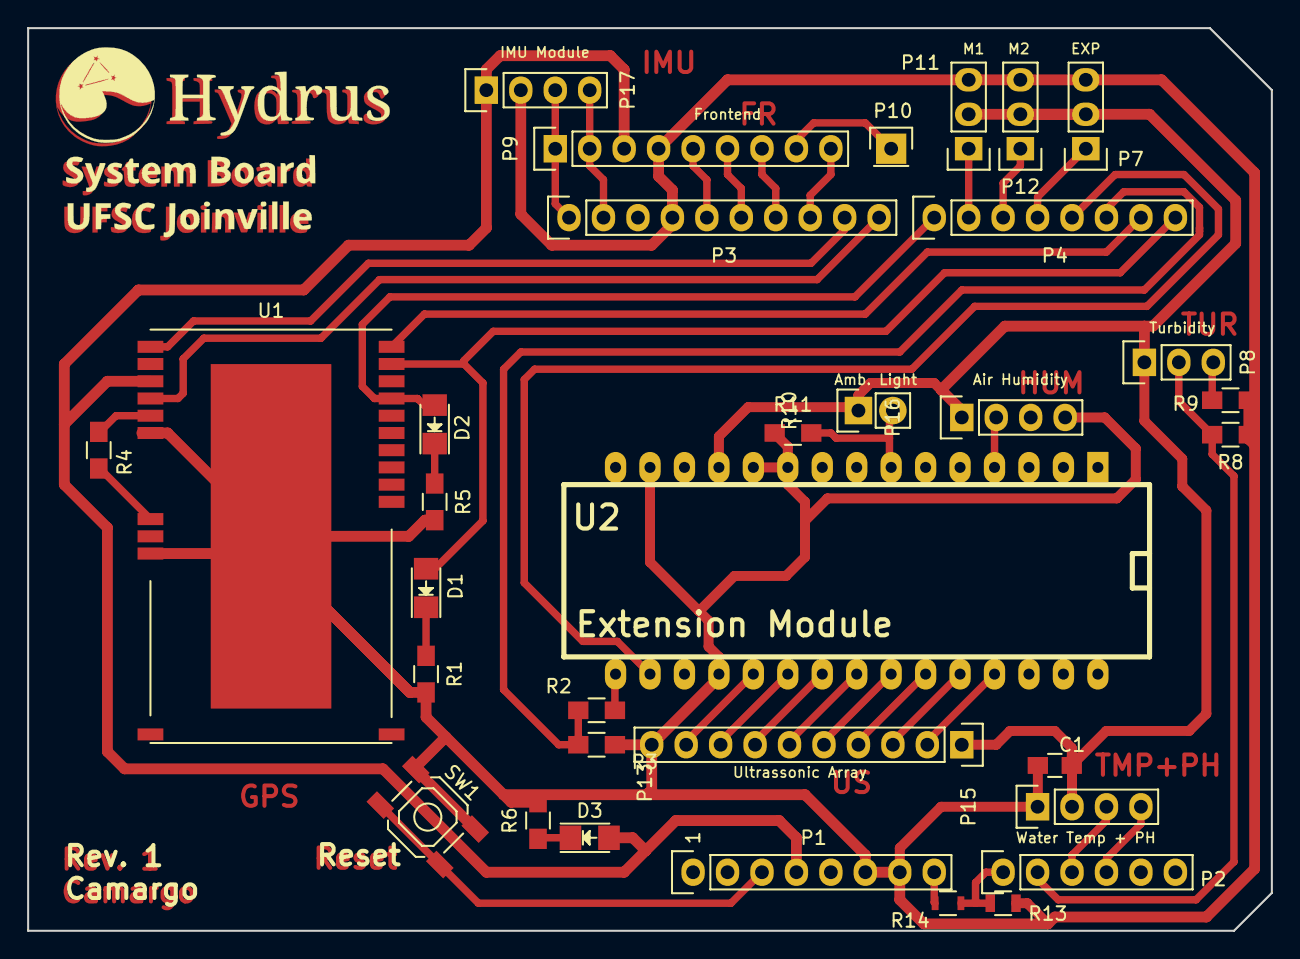
[picture p70: board drone-hw-shield.kicad_pcb from above]

Board: 2 copper layers, 91.7 x 66.5 mm, 33 parts (0 on the bottom side), 43 nets.
