lucaspcamargo/hydrus-v1/drone-hw/drone-v2-systemboard/drone-v2-systemboard.kicad_pcb

## KiCad design drone-hw/drone-v2-systemboard/drone-v2-systemboard.kicad_pcb (2018-08-02)

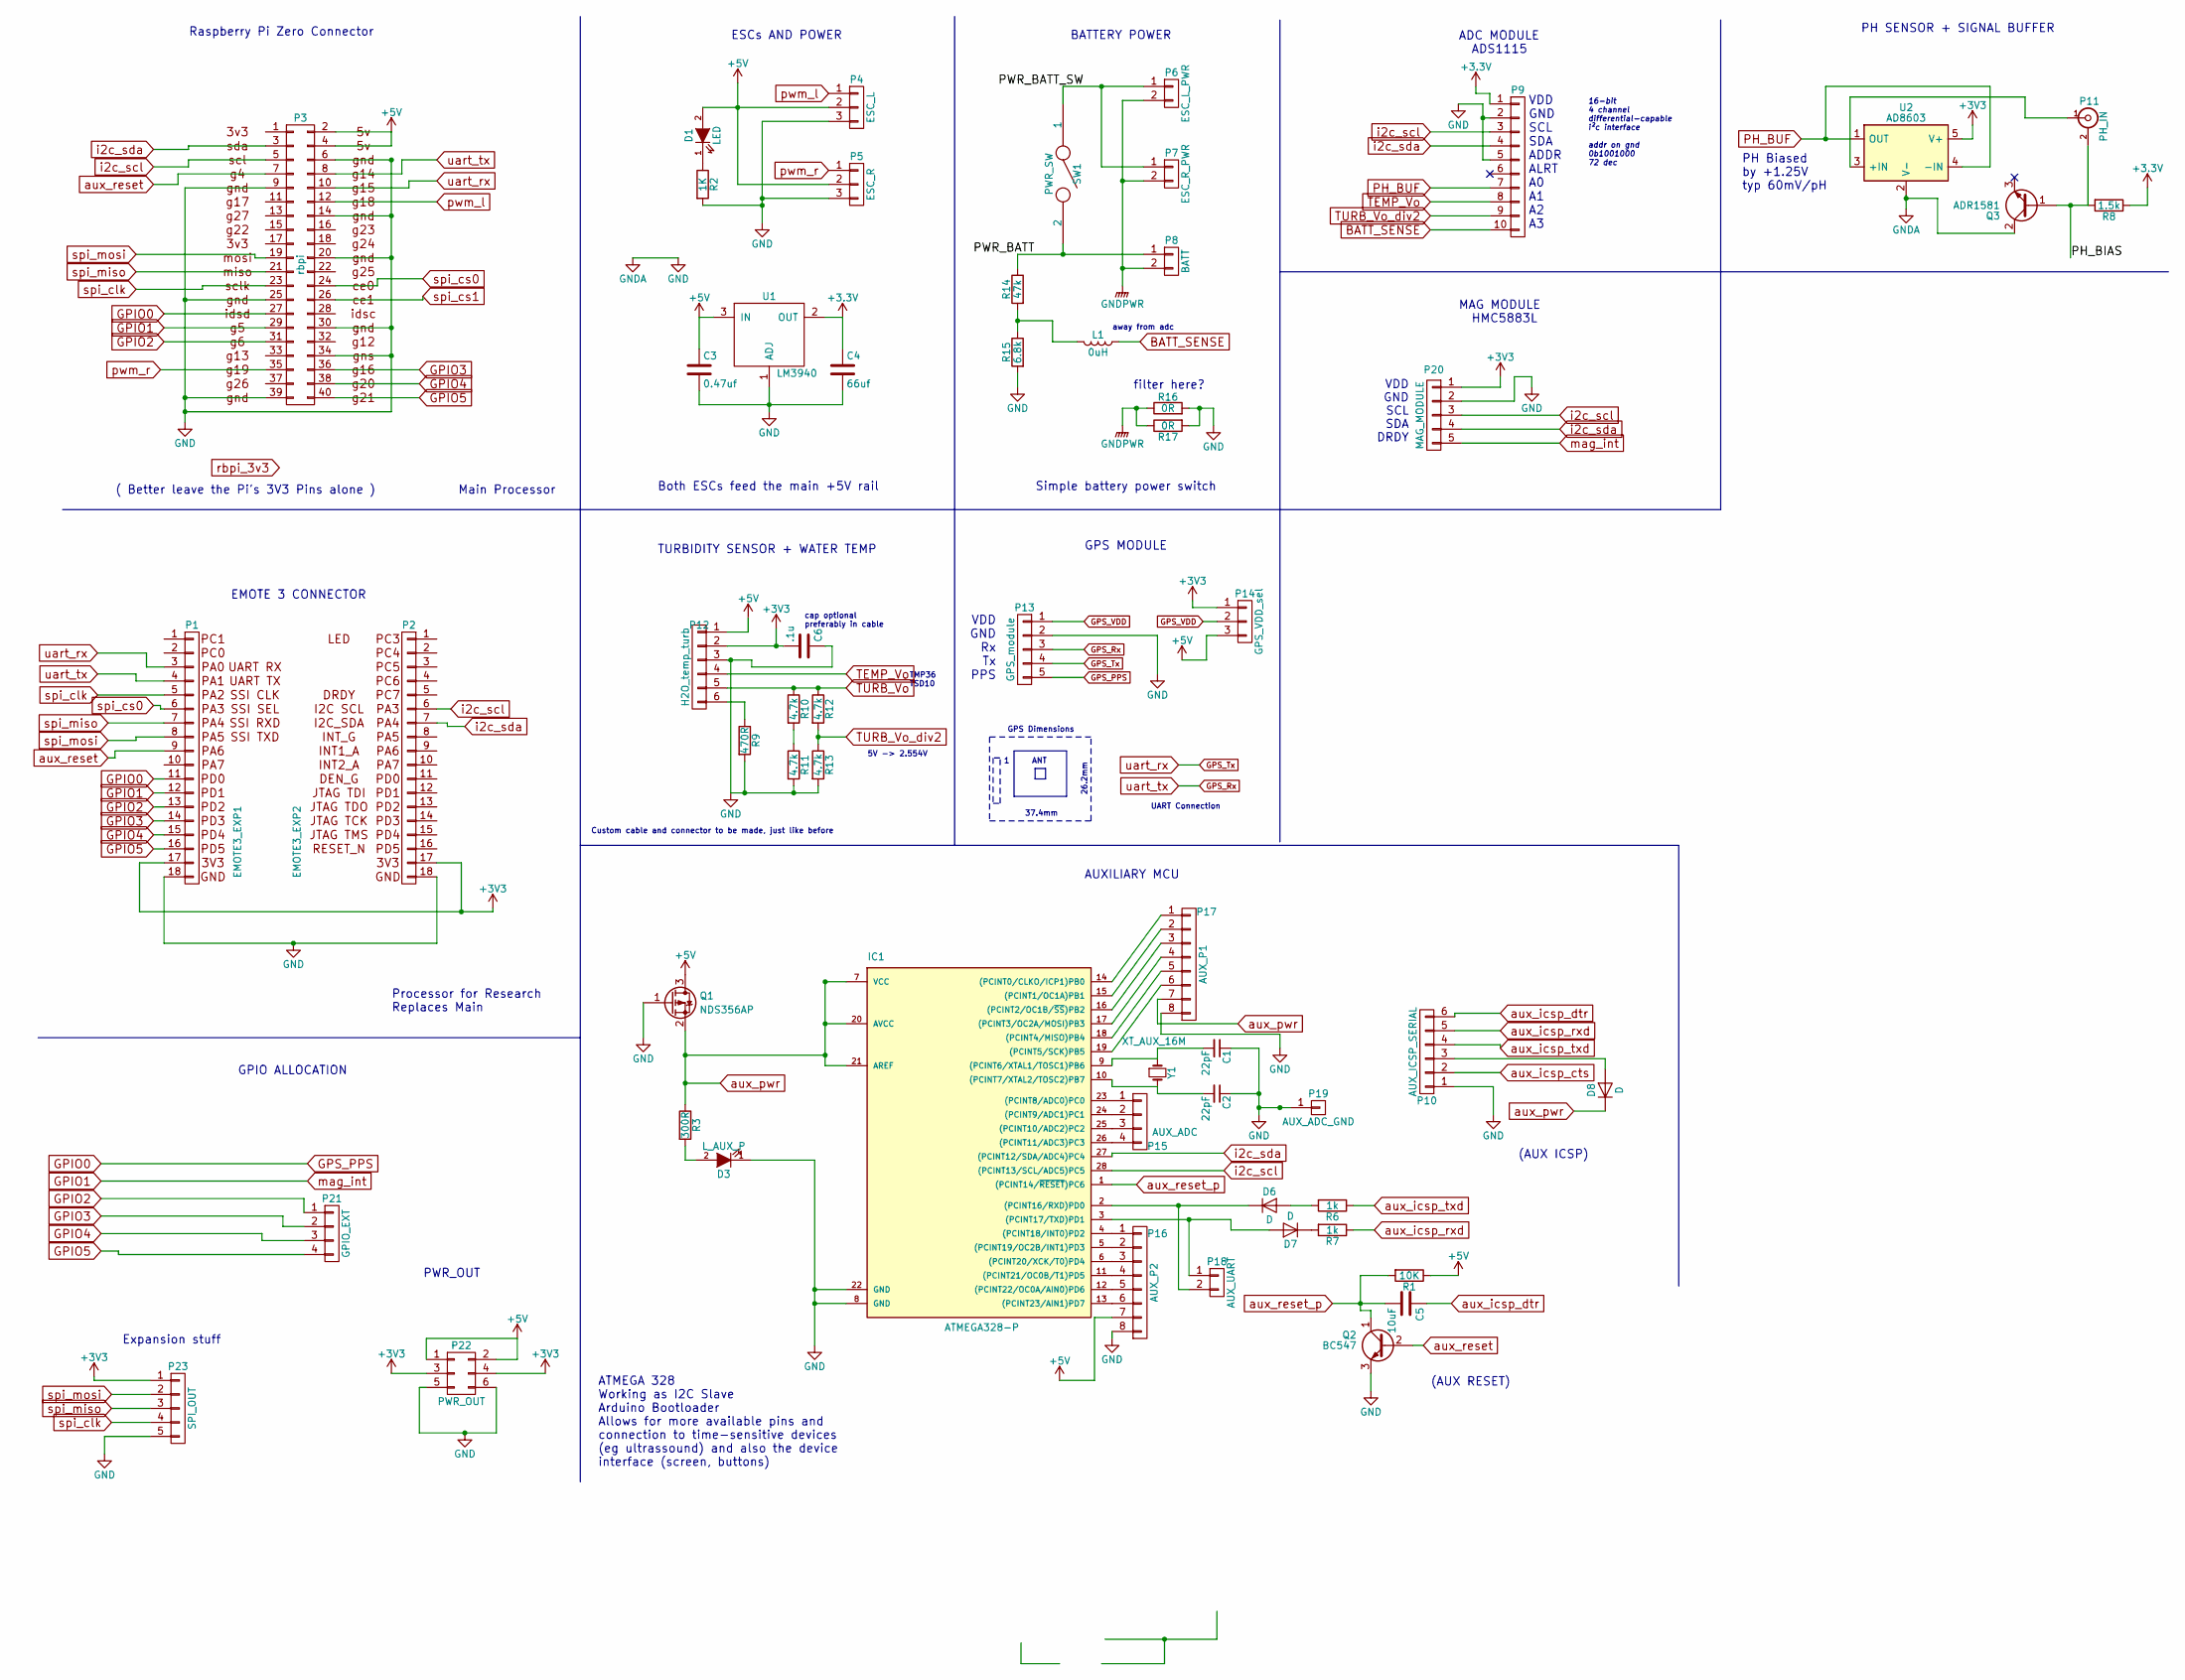
[picture p71: schematic drone-v2-systemboard.sch, Hydrus V2 System Board]

Parts:
C1, C2: 22pF; C_0805_HandSoldering
C3: 0.47uf; C_0805_HandSoldering
C4: 66uf; C_0805_HandSoldering
C5: 10uF; CP_Tantalum_Case-S_EIA-3216-12_Hand
C6: .1u; C_0805_HandSoldering
D1: LED; LED-5MM
D3: L_AUX_P; LED_0805
D6, D7, D8: D; D_SOD-123
IC1: ATMEGA328-P; DIP-28_W7.62mm
L1: 0uH; Inductor_1212
P1: EMOTE3_EXP1; HEADER_18x1_EMOTE
P2: EMOTE3_EXP2; HEADER_18x1_EMOTE
P3: rbpi; Pin_Header_Straight_2x20
P4: ESC_L; Pin_Header_Straight_1x03
P5: ESC_R; Pin_Header_Straight_1x03
P6: ESC_L_PWR; AK300-2
P7: ESC_R_PWR; AK300-2
P8: BATT; AK300-2
P9: ADC_MODULE; Pin_Header_Straight_1x10_Pitch2.54mm
P10: AUX_ICSP_SERIAL; Pin_Header_Straight_1x06_Pitch2.54mm
P11: PH_IN; BNC
P12: H2O_temp_turb; Pin_Header_Straight_1x06_Pitch2.54mm
P13: GPS_module; Pin_Header_Straight_1x05_Pitch2.54mm
P14: GPS_VDD_sel; Pin_Header_Straight_1x03_Pitch2.54mm
P15: AUX_ADC; Pin_Header_Straight_1x04_Pitch2.54mm
P16: AUX_P2; Pin_Header_Straight_1x08_Pitch2.54mm
P17: AUX_P1; Pin_Header_Straight_1x08_Pitch2.54mm
P18: AUX_UART; Pin_Header_Straight_1x02_Pitch2.54mm
P19: AUX_ADC_GND; Pin_Header_Straight_1x01_Pitch2.54mm
P20: MAG_MODULE; Pin_Header_Straight_1x05_Pitch2.54mm
P21: GPIO_EXT; Pin_Header_Straight_1x04_Pitch2.54mm
P22: PWR_OUT; Pin_Header_Straight_2x03_Pitch2.54mm
P23: SPI_OUT; Pin_Header_Straight_1x05_Pitch2.54mm
Q1: NDS356AP; SuperSOT-3
Q2: BC547; TO-92_Inline_Wide
Q3: ADR1581; SOT-23
R1: 10K; R_0805_HandSoldering
R2: 1K; R_0805_HandSoldering
R3: 300R; R_0805_HandSoldering
R6, R7: 1k; R_0805_HandSoldering
R8: 1.5k; R_0805_HandSoldering
R9: 470R; R_0805_HandSoldering
R10, R11, R12, R13: 4.7k; R_0805_HandSoldering
R14: 47k; R_0805_HandSoldering
R15: 6.8k; R_0805_HandSoldering
R16, R17: 0R; R_1210_HandSoldering
SW1: PWR_SW; AK300-2
U1: LM3940; SOT-223-3Lead_TabPin2
U2: AD8603; TSOT-23-5_HandSoldering
Y1: XT_AUX_16M; Crystal_HC49-U_Vertical

Connections:
+5V: C3.1, D1.2 (A), P3.2, P3.4, P4.2, P5.2, P12.1, P14.3, P16.7, P22.1, P22.2, Q1.3 (D), R1.1, U1.3 (IN)
/PH_BIAS: P11.2 (Ext), Q3.1 (B), R8.2
/PWR_BATT: P8.1, R14.1, SW1.2
/PWR_BATT_SW: P6.1, P7.1, SW1.1
BATT_SENSE: L1.1, P9.10
GND: C1.1, C2.1, C3.2, C4.2, C6.1, D3.1 (K), IC1.8 (GND), IC1.22 (GND), P1.18, P2.18, P3.6, P3.9, P3.14, P3.20, P3.25, P3.30, P3.34, P3.39, P4.3, P5.3, P9.2, P9.5, P10.1, P12.3, P13.2, P16.8, P17.8, P19.1, P20.2, P22.5, P22.6, P23.5, Q1.1 (G), Q2.3 (E), Q3.2 (C), R2.2, R9.2, R11.2, R13.2, R15.2, R16.2, R17.2, U1.1 (ADJ), U2.2 (V-)
GNDPWR: P6.2, P7.2, P8.2, R16.1, R17.1
GPIO0: P1.11, P3.27, P13.5
GPIO1: P1.12, P3.29, P20.5
GPIO2: P1.13, P3.31, P21.1
GPIO3: P1.14, P3.36, P21.2
GPIO4: P1.15, P3.38, P21.3
GPIO5: P1.16, P3.40, P21.4
GPS_Rx: P1.4, P3.8, P13.3
GPS_Tx: P1.3, P3.10, P13.4
GPS_VDD: P13.1, P14.2
unnamed: C1.2, IC1.9 ((PCINT6/XTAL1/TOSC1)PB6), Y1.1
unnamed: C2.2, IC1.10 ((PCINT7/XTAL2/TOSC2)PB7), Y1.2
unnamed: D1.1 (K), R2.1
unnamed: D3.2 (A), R3.2
unnamed: D6.1 (K), IC1.2 ((PCINT16/RXD)PD0), P18.2
unnamed: D6.2 (A), R6.2
unnamed: D7.1 (K), R7.2
unnamed: D7.2 (A), IC1.3 ((PCINT17/TXD)PD1), P18.1
unnamed: D8.2 (A), P10.3
unnamed: IC1.4 ((PCINT18/INT0)PD2), P16.1
unnamed: IC1.5 ((PCINT19/OC2B/INT1)PD3), P16.2
unnamed: IC1.6 ((PCINT20/XCK/T0)PD4), P16.3
unnamed: IC1.11 ((PCINT21/OC0B/T1)PD5), P16.4
unnamed: IC1.12 ((PCINT22/OC0A/AIN0)PD6), P16.5
unnamed: IC1.13 ((PCINT23/AIN1)PD7), P16.6
unnamed: IC1.14 ((PCINT0/CLKO/ICP1)PB0), P17.1
unnamed: IC1.15 ((PCINT1/OC1A)PB1), P17.2
unnamed: IC1.16 ((PCINT2/OC1B/~SS~)PB2), P17.3
unnamed: IC1.17 ((PCINT3/OC2A/MOSI)PB3), P17.4
unnamed: IC1.18 ((PCINT4/MISO)PB4), P17.5
unnamed: IC1.19 ((PCINT5/SCK)PB5), P17.6
unnamed: IC1.23 ((PCINT8/ADC0)PC0), P15.1
unnamed: IC1.24 ((PCINT9/ADC1)PC1), P15.2
unnamed: IC1.25 ((PCINT10/ADC2)PC2), P15.3
unnamed: IC1.26 ((PCINT11/ADC3)PC3), P15.4
unnamed: L1.2, R14.2, R15.1
unnamed: P11.1 (In), U2.3 (+IN)
unnamed: P12.6, R9.1
unnamed: R10.2, R11.1
PH_BUF: P9.7, U2.1 (OUT), U2.4 (-IN)
TEMP_Vo: P9.8, P12.4
TURB_Vo: P12.5, R10.1, R12.1
TURB_Vo_div2: P9.9, R12.2, R13.1
aux_icsp_dtr: C5.1, P10.6
aux_icsp_rxd: P10.5, R7.1
aux_icsp_txd: P10.4, R6.1
aux_pwr: D8.1 (K), IC1.7 (VCC), IC1.20 (AVCC), IC1.21 (AREF), P17.7, Q1.2 (S), R3.1
aux_reset: P1.9, P3.7, Q2.2 (B)
aux_reset_p: C5.2, IC1.1 ((PCINT14/~RESET~)PC6), Q2.1 (C), R1.2
i2c_scl: IC1.28 ((PCINT13/SCL/ADC5)PC5), P2.6, P3.5, P9.3, P20.3
i2c_sda: IC1.27 ((PCINT12/SDA/ADC4)PC4), P2.7, P3.3, P9.4, P20.4
pwm_l: P3.12, P4.1
pwm_r: P3.35, P5.1
spi_clk: P1.5, P3.23, P23.4
spi_cs0: P1.6, P3.24
spi_miso: P1.7, P3.21, P23.3
spi_mosi: P1.8, P3.19, P23.2

Notes on the sheet:
EMOTE 3 CONNECTOR
Raspberry Pi Zero Connector
ESCs AND POWER
BATTERY POWER
AUXILIARY MCU
ADC MODULE ADS1115
(AUX RESET)
(AUX ICSP)
PH SENSOR + SIGNAL BUFFER
Both ESCs feed the main +5V rail
Simple battery power switch
TURBIDITY SENSOR + WATER TEMP
Main Processor
Processor for Research Replaces Main
PH Biased by +1.25V typ 60mV/pH
VDD GND SCL SDA ADDR ALRT A0 A1 A2 A3
16-bit 4 channel differential-capable i²c interface addr on gnd 0b1001000 72 dec
filter here?
away from adc
GPIO ALLOCATION
TMP36 TSD10
GPS MODULE
VDD GND Rx Tx PPS
26.2mm
37.4mm
ANT
GPS Dimensions
Custom cable and connector to be made, just like before
5V -> 2.554V
cap optional preferably in cable
VDD GND SCL SDA DRDY
MAG MODULE HMC5883L
ATMEGA 328 Working as I2C Slave Arduino Bootloader Allows for more available pins and connection to time-sensitive devices (eg ultrassound) and also the device interface (screen, buttons)
UART Connection
PWR_OUT
Expansion stuff
( Better leave the Pi's 3V3 Pins alone )

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
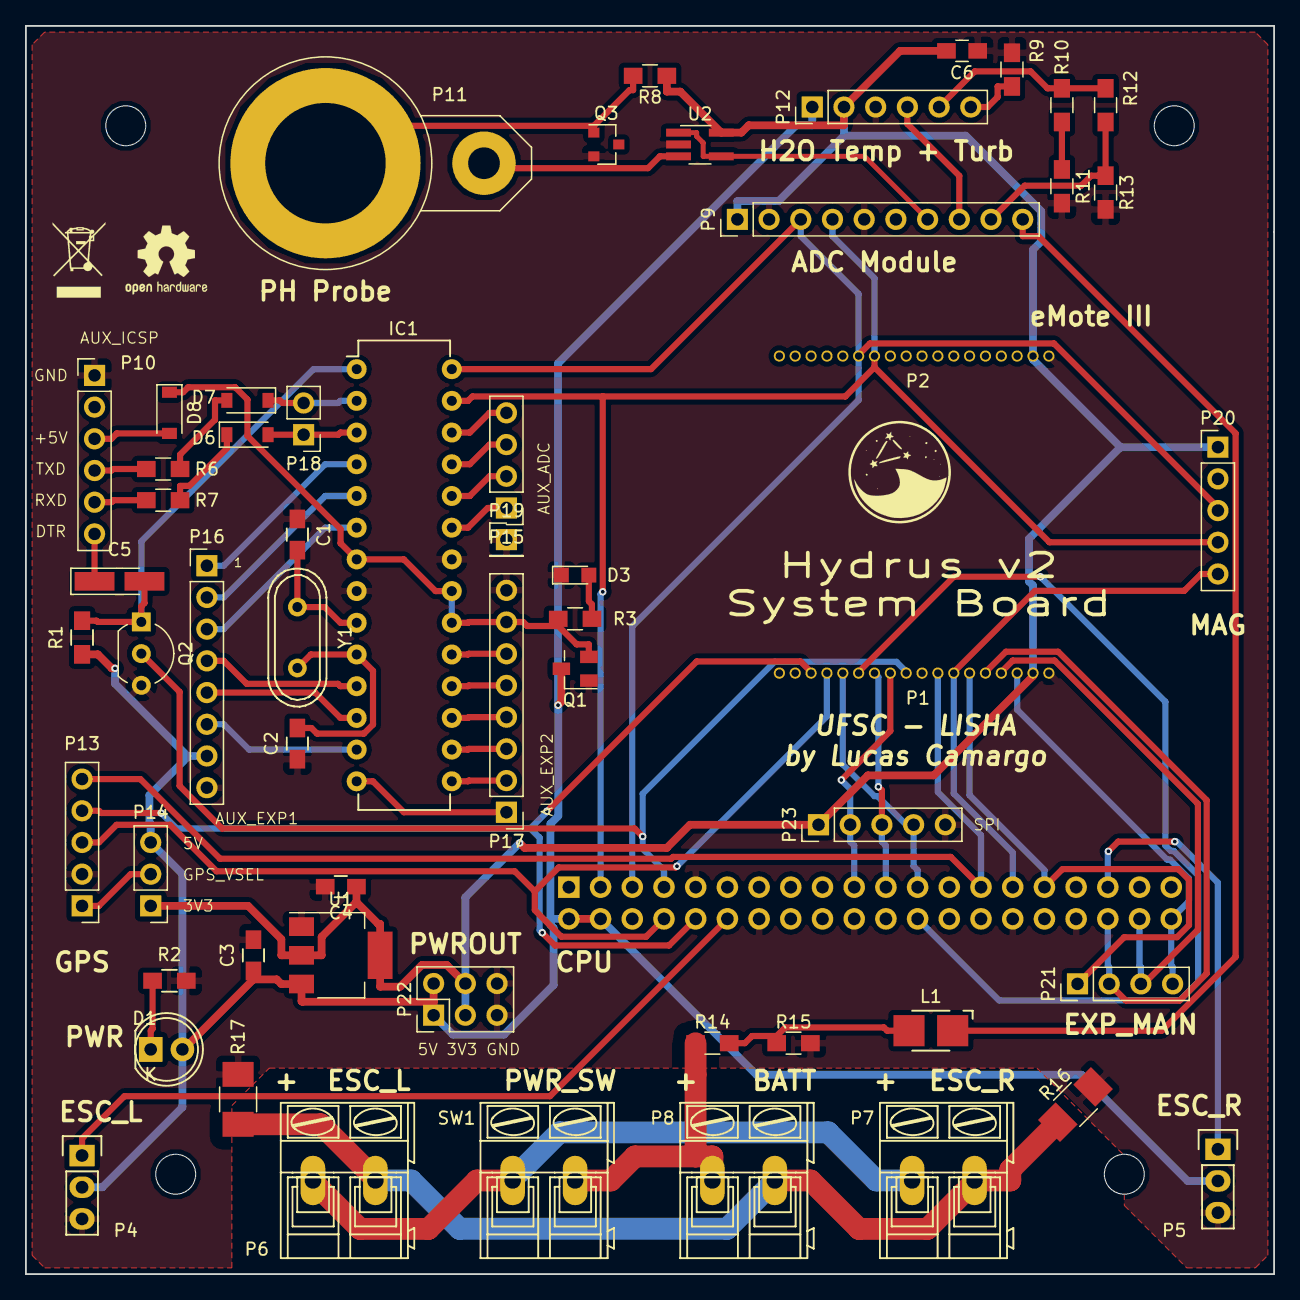
[picture p72: board drone-v2-systemboard.kicad_pcb from above]

Board: 2 copper layers, 100.0 x 100.0 mm, 64 parts (1 on the bottom side), 64 nets.

Other parts of the board:
HOLE1, HOLE2, HOLE3, HOLE4: MountingHole_3.2mm_M3_DIN965
oshwlogo: OSHW-Logo2_7.3x6mm_SilkScreen
weeelogo: WEEE-Logo_4.2x6mm_SilkScreen
