lucaspcamargo/hydrus-v1/drone-firmware/drone-firmware/etc_basic_font.h

#pragma once

const unsigned char BasicFont[][8] =
{
  {0x00,0x00,0x00,0x00,0x00,0x00,0x00,0x00},
  {0x00,0x00,0x5F,0x00,0x00,0x00,0x00,0x00},
  {0x00,0x00,0x07,0x00,0x07,0x00,0x00,0x00},
  {0x00,0x14,0x7F,0x14,0x7F,0x14,0x00,0x00},
  {0x00,0x24,0x2A,0x7F,0x2A,0x12,0x00,0x00},
  {0x00,0x23,0x13,0x08,0x64,0x62,0x00,0x00},
  {0x00,0x36,0x49,0x55,0x22,0x50,0x00,0x00},
  {0x00,0x00,0x05,0x03,0x00,0x00,0x00,0x00},
  {0x00,0x1C,0x22,0x41,0x00,0x00,0x00,0x00},
  {0x00,0x41,0x22,0x1C,0x00,0x00,0x00,0x00},
  {0x00,0x08,0x2A,0x1C,0x2A,0x08,0x00,0x00},
  {0x00,0x08,0x08,0x3E,0x08,0x08,0x00,0x00},
  {0x00,0xA0,0x60,0x00,0x00,0x00,0x00,0x00},
  {0x00,0x08,0x08,0x08,0x08,0x08,0x00,0x00},
  {0x00,0x60,0x60,0x00,0x00,0x00,0x00,0x00},
  {0x00,0x20,0x10,0x08,0x04,0x02,0x00,0x00},
  {0x00,0x3E,0x51,0x49,0x45,0x3E,0x00,0x00},
  {0x00,0x00,0x42,0x7F,0x40,0x00,0x00,0x00},
  {0x00,0x62,0x51,0x49,0x49,0x46,0x00,0x00},
  {0x00,0x22,0x41,0x49,0x49,0x36,0x00,0x00},
  {0x00,0x18,0x14,0x12,0x7F,0x10,0x00,0x00},
  {0x00,0x27,0x45,0x45,0x45,0x39,0x00,0x00},
  {0x00,0x3C,0x4A,0x49,0x49,0x30,0x00,0x00},
  {0x00,0x01,0x71,0x09,0x05,0x03,0x00,0x00},
  {0x00,0x36,0x49,0x49,0x49,0x36,0x00,0x00},
  {0x00,0x06,0x49,0x49,0x29,0x1E,0x00,0x00},
  {0x00,0x00,0x36,0x36,0x00,0x00,0x00,0x00},
  {0x00,0x00,0xAC,0x6C,0x00,0x00,0x00,0x00},
  {0x00,0x08,0x14,0x22,0x41,0x00,0x00,0x00},
  {0x00,0x14,0x14,0x14,0x14,0x14,0x00,0x00},
  {0x00,0x41,0x22,0x14,0x08,0x00,0x00,0x00},
  {0x00,0x02,0x01,0x51,0x09,0x06,0x00,0x00},
  {0x00,0x32,0x49,0x79,0x41,0x3E,0x00,0x00},
  {0x00,0x7E,0x09,0x09,0x09,0x7E,0x00,0x00},
  {0x00,0x7F,0x49,0x49,0x49,0x36,0x00,0x00},
  {0x00,0x3E,0x41,0x41,0x41,0x22,0x00,0x00},
  {0x00,0x7F,0x41,0x41,0x22,0x1C,0x00,0x00},
  {0x00,0x7F,0x49,0x49,0x49,0x41,0x00,0x00},
  {0x00,0x7F,0x09,0x09,0x09,0x01,0x00,0x00},
  {0x00,0x3E,0x41,0x41,0x51,0x72,0x00,0x00},
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
};
