lucaspcamargo/hydrus-v1/(commit log)

2018-08-02 Initial import
    [axle-adapter.stl, drone-alt-phmeter.kicad_pcb, drone-alt-phmeter.sch, drone-hw-shield.kicad_pcb, drone-hw-shield.sch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]
2018-08-02 deleted useless things
    [emote2-gsm_gps-pcb_document.GBL, emote2-gsm_gps-pcb_document.GBO, emote2-gsm_gps-pcb_document.GBP, emote2-gsm_gps-pcb_document.GBS, emote2-gsm_gps-pcb_document.GKO, emote2-gsm_gps-pcb_document.GTL, emote2-gsm_gps-pcb_document.GTO, emote2-gsm_gps-pcb_document.GTP]
